DrEVILish/inferno-esp32-usb/docs/13-review-2026-10-13.md

# 13 — Cross-module review (A1), 2026-10-13

Scope: all of `firmware/main` after the merge of the three modules (usb/,
net/+clock/, aoip/), read at the seams: ring contracts, ISR/IRAM safety,
cores and priorities, init order, epoch handling, error paths, atomics. The
AoIP control plane (ARC, CMC, flow control, subscriber, mDNS, info) was
reviewed by a second reader in parallel. Nothing here has run on hardware.

Line numbers refer to branch `feat/harden` after the fixes.

## 1. Fixed

| # | where | severity | what went wrong | fix |
|---|---|---|---|---|
| 1 | `clock/mediaclock.c:100` `mc_hw_step`; `usb/uac2.c:126`; `aoip/flows_tx.c:313` | high | The step bumped the epoch *after* leaving its critical section, and the SOF ISR read `mc_now_ns()` then `mc_epoch()` (the packetizer the other way round). A step on core 0 between the two reads paired a time from one timescale with the epoch of the other: the USB engine re-anchored OUT/IN on the old timescale under the new epoch, then saw a jump (`sof_gaps`/refit, IN re-anchor = audible); the packetizer bootstrapped flows on the wrong timescale and reset them again. | `mc_now_ns_epoch()` (IRAM): a seqlock reader. The step brackets the counter write *and* the epoch increment with a sequence counter inside the critical section. Both audio users read the pair through it. |
| 2 | USB interrupt (TinyUSB `dwc2_esp32.h`) | high | Allocated without `ESP_INTR_FLAG_IRAM`, handler and `dcd_dwc2.c`/`usbd.c` in flash: every NVS write masked USB for its whole duration (ms; tens of ms for an erase) → OUT/IN re-anchors. | A2: `esp_intr_alloc` wrapped at link time (`-Wl,--wrap`), IRAM flag added for `ETS_USB_OTG_INTR_SOURCE`; `main/linker.lf` moves TinyUSB's ISR path to IRAM/DRAM; `tools/check_iram.py` proves the call graph after each build (§3). |
| 3 | `app_config.h:167` `UI_PRIO_PTP` | med | PTP task and TX packetizer shared priority 22 on core 0. Before each Delay_Req the PTP task busy-waits up to ~1 ms for the TX DMA and then polls for the TX timestamp; at equal priority (no preemption) a due audio packet could wait past its 1 ms deadline. | PTP → 20 (below the packetizer, above everything on core 1 that matters). PTP needs no scheduling latency: all its timestamps are hardware. |
| 4 | `clock/ptpv1.c:179,377` | med | A Sync queued while the servo stepped the clock carried a pre-step t2; on the new timescale it reads as an offset of the whole step → the servo steps straight back (ping-pong) when two Syncs are queued around a step. | Events carry `mc_epoch()` from the hook; Syncs from an older epoch are dropped. |
| 5 | `aoip/settings_nvs.c` flush | low | `s_dirty` was cleared before `nvs_open`; on an error the change was never written. Error log printed a stale `err`. | A3 rewrite: dirty bits restored and retried after another quiet period; `err` set on every failure path. |
| 6 | `audio/ring.h` counters, `sys/telem.c` | low | `ring_n2u_underruns`, `ring_n2u_late`, `ring_u2n_underruns` were exported but never incremented, yet docs/21 uses `ring_*` as pass criteria. | Wired: TX packet from unwritten OUT frames, USB IN re-anchor, late RX packet. |
| 7 | `aoip/subscriber.c:188` | med | ARC unsubscribe followed quickly by subscribe: `sub_subscribe()` sets the status at once, then the *earlier* queued UNSUBSCRIBE wipes it and nothing restores it. ARC shows the channel unpatched while it is patched (and saved to NVS). | `subscribe_internal()` restores the status if an earlier unsubscribe cleared it. |
| 8 | `aoip/arc.c:193` | med | Renaming TX channel 1 to "02" (channel 2's factory name): the mDNS add fails, and renaming channel 1 back later removes *channel 2's* service. | A rename to a name another TX channel uses (factory or friendly) is refused. |
| 9 | `aoip/flowctl_server.c` | low | fpp 1 accepted (only 0 refused): a peer could make us send 48 k packets/s per flow. | `fpp < TX_FPP_MIN` → 0x0302, as Inferno. |
| 10 | `aoip/aoip.c:159` | low | `sub_start()` ran before `info_set_socket()` created the RX-channel notify queue: early notifications dropped, queue pointer published without ordering. | Subscriber task starts after the queue exists. |
| 11 | `aoip/subscriber.c:150` | low | Two 2 KB `saved_sub_t[32]` locals on the 6 KB subscriber stack. | `static` (subscriber task only). |
| 12 | `aoip/subscriber.c` flow request, `aoip/proto.h` | med (new with the latency profiles) | We asked transmitters for their maximum fpp (32 for Inferno = 0.67 ms) and advertised fpp 32 for our own TX, regardless of latency. At 0.5 / 0.25 ms AoIP latency every packet would be late. | fpp capped at `UI_TX_FPP_MAX` of the latency profile (32 at 1 ms, 8 at 0.5 ms, 4 at 0.25 ms); multicast bundles and mDNS `fpp=` follow it. |
| 13 | `usb/uac2.c` DMA buffers | build break (new) | `UAC2_EP_DATA_MPS % 64 == 0` asserted: only true for 16 and 32 channels. | Buffers rounded up to whole cache lines; the endpoint keeps the exact MPS. |
| 14 | `app_config.h` model strings | low (new) | "USB-Inferno 32x32" / `UI3232-` in every channel build. | Derived from `UI_CHANNELS` (32 → unchanged). |
| 16 | `audio/ring.h` `RING_FRAMES`, memory budget | high | Internal heap is ≈ 393 KB (768 KB L2MEM − 128 KB L2 cache − 72 KB ROM reserve − 188 KB static), not "768 KB minus a little". Two 1024-frame rings (256 KB) + EMAC DMA (96 KB at 30+30) left ≈ 40 KB for every task stack, lwIP and mDNS: very likely a boot failure (`ring_init`/EMAC alloc → abort) or starved lwIP. With A4's 64 RX buffers it would certainly not fit. | `RING_FRAMES` 1024 → 512 (10.7 ms; bounds: transmitter latency up to ours + 5.3 ms, OUT lead ≤ 5.3 ms, loopback delay 192 fit). `ENG_OUT_LEAD_MAX` follows the ring. Budget in docs/01 §8; `heap_internal_min_free` telemetry and a boot log line. |
| 15 | `usb/uac2_engine.h` OUT underrun thresholds | low (new) | `lead < 24` and `w − now < 12` were absolute; with a 12-frame lead they would re-anchor constantly. | `ENG_OUT_LEAD_MIN = max(4, lead/2)`, real-time check `(LEAD_MIN − 6)/2` (lead 48: 24/9, lead 12: 6/0). |

## 2. Checked, no change needed

- **Ring contracts.** Indices are media frames everywhere (RX: packet
  `sec·48000+sub` + shift; TX: packet timestamp = ring index of its first
  frame; USB: SOF media frame ± lead/latency). Samples are left-justified
  int32 on both sides (RX decode `<<8`/`<<16`, 32-bit input masked to 24;
  TX takes the top bytes). `net_to_usb` is read-and-cleared by USB IN only in
  production; the NET_LOOPBACK and USB_LOOPBACK builds never clear it (TX
  resp. nobody reads it). `ring_valid()` window `head − frame ≤ 960` holds
  with lead ≤ 48 + fpp ≤ 32 + lag ≤ 48.
- **RX late check vs IN read.** IN reads frames `< sof_f − L − m` (m = IN
  margin), `sof_f` on the lower envelope of SOF times, so never later than
  the read itself; the RX hook drops a packet if its first ring frame is
  `< now − L`. Any accepted frame is therefore unread, and a read frame is
  never written later, provided the hook writes within m frames (+ ISR
  latency) of reading `now` (it runs at the highest task priority, µs). With
  m = 3 frames (62 µs, was 6) — docs/14-latency.md.
- **64-bit atomics on rv32 (`audio_ring_t.head`).** Not lock-free: GCC emits
  `__atomic_load_8/__atomic_store_8`, which IDF's `esp_libc/stdatomic.c`
  implements with one global `portENTER_CRITICAL_SAFE` spinlock. That is
  correct across cores and in ISRs (SAFE variant), and the code is in IRAM
  (`CONFIG_LIBC_MISC_IN_IRAM=y`; `check_iram.py` walks into it). Cost: one
  short global spinlock per ring head access (USB ISR write, packetizer
  `ring_valid`). Acceptable; a seqlock or 32-bit head would remove it if
  profiling ever shows contention.
- **Cache maintenance for DMA.** TinyUSB cleans IN buffers before arming
  (`dcd_edpt_xfer`) and invalidates OUT buffers before the completion
  callback; our buffers are 64-byte aligned, whole lines, and the CPU never
  writes the OUT buffers (no dirty lines to evict over DMA data). The 4-byte
  feedback buffer is a full line.
- **Init order** (`app_main.c`): NVS → rings → `net_start` (esp_netif/lwIP
  init, EMAC, 1588 enable) → `mc_start` (counter init, PTP task/hook/join)
  → `uac2_start` (SOF ISR uses an initialised counter) → `aoip_start`
  (sockets after lwIP; binds to INADDR_ANY work before an address) →
  telemetry. Before link/IP: joins fail with INVALID_STATE and the
  `net_maint` task re-joins on link-up; TX destinations stay unresolved and
  are retried by `ftx_tick`.
- **Multicast contract.** RX bundles join via `net_mcast_join()` (239/8 fast
  path filter), PTP joins 224.0.1.129 the same way.
- **Test variant routing.** USB_LOOPBACK: IN reads `usb_to_net` at
  `now − 192` (non-clearing); NET_LOOPBACK: TX reads `net_to_usb` at
  `ts − L` without clearing, USB IN sends silence and never clears; TONE:
  TX ignores rings.
- **Stacks.** EMAC RX 6 KB (hooks use < 300 B), packetizer 4 KB (packet
  buffer static), USB task 4 KB (control requests only), ctl 8 KB, sub
  6 KB (after fix 11), telemetry 4 KB (8 KB buffer is static).
- **Integer wrap.** 64-bit frame indices everywhere on the audio path;
  32-bit ms timestamps compared by subtraction.

## 3. IRAM check (A2) — what it covers

`tools/check_iram.py <elf>` (run by `tools/build.sh` and
`tools/build-variant.sh` / `build-matrix.sh` after every build):

- Roots: `dwc2_int_handler_wrap` (TinyUSB DWC2 ISR), `uac2_sof_isr`,
  `uac2_xfer_isr` (called through the class driver table), the AoIP TX
  `timer_cb` (esp_timer ISR dispatch).
- Edges: direct calls/jumps, plus loaded function addresses (treated as
  possible indirect calls). Result today: 70 functions reachable, all in
  IRAM or ROM.
- Data: references to `.flash.rodata`/PSRAM fail the check for our code and
  TinyUSB (e.g. it caught `_dwc2_controller`, a const table in flash, before
  the linker fragment moved it). IDF's own IRAM functions reference flash
  only for assert strings; those are reported with `-v`, not failed.
- Justified exceptions (`ALLOW` in the script): FIFO mutex paths in
  `tusb_fifo.c` (no FIFO has a mutex: our driver uses plain buffers),
  `dcd_event_handler → xQueueGenericSend` (task branch; in the ISR it is the
  FromISR call), `prvCopyDataToQueue → xTaskPriorityDisinherit` (mutexes
  only).
- Not covered statically: the data the ISR touches through pointers set at
  run time (`g_ring_*.buf` from `heap_caps_aligned_calloc(INTERNAL|DMA)`,
  DMA buffers in `.bss`) — internal RAM by construction.
- `uac2_start()` logs an error if the `esp_intr_alloc` wrap did not run.

## 4. Not fixed (with reason)

| where | issue | why not now |
|---|---|---|
| `net/net.c` hooks | Re-registering a hook slot while the RX task is inside the old hook can call the new `fn` with the old range for one frame. | `net_udp_hook_unregister()` is never called; all hooks are registered once at start. |
| `aoip/aoip_mdns.c` A-record fallback | `mdns_query_a()` (3 s) runs per channel, serially; 32 subscriptions to one badly-announcing host can block the subscriber ~100 s. | Control-plane latency only; cache per hostname when it is seen on the bench. |
| `aoip/*` under `aoip_lock` | `frx_add_flow` quiesce (2 ms) and socket work, `publish()` waiting for the packetizer ack, NVS flush, `mdns_hostname_set` run under the recursive lock. | Stalls the ctl/sub tasks only (no lock-order cycle: tcpip, mdns, packetizer and the EMAC hook never take it). |
| `aoip/subscriber.c` | `fpp = max(fpp_min, …)` can exceed the latency cap / MTU when a transmitter's minimum is large. | The transmitter would refuse or we count `rx_late`; Dante/Inferno minimum is 2–16. |
| `aoip/flowctl_client.c` | OK reply shorter than 6 bytes: error returned, transmitter keeps the flow until keepalive timeout. | Harmless. |
| NVS blobs | Their size depends on `UI_CHANNELS`; flashing a different channel build drops names/subscriptions (length check → defaults). | Test builds only; production is one channel count. |
| Flash writes vs network | The network side (EMAC RX task, packetizer, lwIP) is flash-resident and pauses during an NVS write; USB keeps running (A2). | Moving the whole network fast path to IRAM is large; A3 makes writes rare and controller-initiated. Option for later: `CONFIG_SPI_FLASH_AUTO_SUSPEND` (P4 supports it; flash-part dependent). |
| USB OUT lead vs ISR stalls | No lead ≤ 1 ms absorbs a 1 ms USB ISR blackout without an OUT re-anchor (simulated). | Post-A2 there is no known source of ms stalls; docs/14 states the assumption. |
| `tools/aoip_probe.py` `paged()` | Pages 0x2200/0x3200 by count instead of slot index; sparse tables page wrongly. | Bench tool; fix when used against sparse tables. |

## 5. Follow-up fixes on main

Without hardware; each is control-plane only and keeps the audio-path contracts
of §2 (hook/packetizer never take `aoip_lock`).

- **A-record fallback cache** (`aoip/aoip_mdns.c`): hostname→IPv4 cache
  (`s_host_cache`, 8 entries, round-robin eviction) in front of `mdns_query_a()`,
  refreshed whenever an SRV answer already carries an IPv4 address. Worst case
  for 32 subscriptions to one badly-announcing host drops from ~32 × 3 s to
  ~1 × 3 s. Cache lives in the subscriber task (sole caller of
  `aoip_mdns_query_chans`); no locking.
- **fpp clamp** (`aoip/subscriber.c`, new `aoip/fpp.h`): `fpp_min` above the
  MTU cap now refuses the flow (`SUB_STATUS_TX_FAIL`) instead of requesting
  fragmenting packets that `net.c` drops; above only the latency cap it requests
  the minimum with a warning (degraded, counted in `rx_late`). Selection logic
  is pure and host-tested (`tools/fpp_select_test.c`).
- **Lock scope** (`aoip/aoip.c`, `aoip/flows_rx.c`, `aoip/arc.c`,
  `aoip/aoip_mdns.c`): `settings_flush_if_due()` (NVS commit, self-locking)
  and the deferred device-rename `aoip_mdns_publish_all()` now run after the
  ctl-loop `aoip_unlock()`; `frx_add_flow`/`frx_remove_flow` open/close the
  keepalive sockets, IGMP join/leave, and `quiesce()` outside the lock (lock
  covers only the state swap; the hook bails on inactive slots);
  `frx_connect/disconnect_channel` run `rebuild_map()` (possible 2 ms quiesce)
  unlocked — only the subscriber task mutates the channel map, and the hook
  reads the new table through the `map_idx` acquire/release handoff.
  Still under the `serve()` hold by design (handlers assume it; audit-free):
  the whole ARC/CMC/FCS dispatch and `publish()`'s packetizer-ack wait.

## 6. Critical/warning fixes on main (2026-10-14)

Traced with the Code Mode tool catalog review. Each verified against the
sources; the clock fixes are the ones that previously left the servo chasing
a phantom.

| # | where | what was wrong | fix |
|---|---|---|---|
| 1 | `mediaclock.c` step/freq | `mc_hw_step()` ignored the `hw_set_time()` failure and bumped the epoch anyway: the servo believed the step applied when the clock never moved — non-converging step loop on a wedged `wait_ctrl_idle()`. `mc_hw_set_freq_ppb()` silently skipped the addend with no signal. | both return `bool`; epoch/seq no longer move on a failed step; failure counters `ptp_hw_step_fails`/`ptp_hw_freq_fails` in telemetry; `apply()` keeps in-flight timestamps on a failed step (they are still on the current timescale). |
| 2 | `uac2_engine.c` `eng_in_packet` | rendered + cleared + advanced `r` before the arm result: a persistent `usbd_edpt_xfer` failure silently discarded fresh RX audio every microframe. | split into `eng_stage_in_packet` (render, no consume) + `eng_commit_in_packet` (advance + clear + counters, only after arm success); `arm_in()` stages, arms, commits. `eng_in_packet` = stage+commit for the host sim. |
| 3 | `uac2_engine.c` gap fill | the fill cap scaled with the unbounded `gap`; a huge fill jumped the ring head far past `now` before the overrun re-anchor ran. | fill is skipped when the estimate exceeds `ENG_OUT_LEAD_MAX` (discontinuity, not a gap): the re-anchor handles it with a bounded position reset. |
| 4 | `audio/ring.c` head | `ring_write_frames/silence` stored `head = frame + n` unconditionally: an out-of-order/re-anchor write regressed the published head (previously valid ranges read as underruns; content/reader overlaps possible). | `ring_publish_head()`: monotone — head only advances. |
| 5 | `uac2.c` stale OUT completion | a completion latched before SET_INTERFACE could be consumed as the new session's first packet. | session era: `s_out_era` bumped per set_interface, arm records its era, mismatched completions are swallowed. |
| 6 | `tx_multicasts.c` remove | bundle state was cleared before the TX-flow removal was known to succeed → device kept streaming a multicast that persisted state no longer knew. | remove the flow first; only on success clear + mDNS-remove + persist. |
| 7 | `flowctl_server.c` | destination never sanity-checked (any LAN datagram could point the 32-ch TX stream anywhere, including through the gateway); every `ftx_add_flow` failure was reported as 0x0315. | refuse 0.0.0.0 / 255.255.255.255 / 127/8 / port 0 (0x0302); `ESP_ERR_NO_MEM` → 0x0315, others → 0x0302. |
| 8 | `info_mcast.c` | unauthenticated info requests entered at line rate (each answered with a byte-heavy multicast). | token bucket (1 per 250 ms, burst 32); refusals counted (`aoip_info_drops`). |
| 9 | `ptpv1.c` bring-up | hook-registration failure left a permanently dead follower (log-only, no retry). | retry from `ptp_task` before its main loop (6 × 5 s), then a permanent-failure log; mcast join failure tolerated — `net_maint` re-joins every second while the link is up. |
| 10 | `ptp_servo.c` HOLD_MAX | unlock left the outlier window stale → median mixed pre/post-re-anchor samples. | `outl_n = 0` like the other unlock path. |
| 11 | `uac2.c` open/set_interface | endpoint alloc/activate failures had no counter and no log; `uac2_start()` timeout leaked the usb task and double-initialised on retry; GET controls ignored `wLength`; unknown-EP completions were claimed as handled. | `usb_ep_errors` counter + logs; `started` set before the wait (no second task); `wLength` guards on the three GET paths; `xfer_isr` returns false for foreign EPs. |
| 12 | Wires hardening | device rename accepted non-NUL-terminated/over-long names silently and skipped the fork's first-char/trailing-'-' rules. | NUL required, ≤ 30 chars, starts with a letter, no trailing '-'. |
| 13 | Engine IN re-anchor | `reanchor_in(target − NOMINAL)` underflowed at early boot (`target < 6`). | clamped like `reanchor_out`. |
| 14 | tools | PID-predictable /tmp dirs (compiled binaries executed from them), `esp_eth_override` `rm -rf` before validating the source + default fuzz patching, `check_iram` mislabelled tool errors as violations, descriptor checker crashed on malformed input, fixed `/tmp` build lock, unvalidated variant name injected into Kconfig, `net_stats` tracebacked on bad args/DNS, `usb_loopback_test` leaked its temp dir. | mktemp everywhere; pre-validate + `patch --fuzz=0` +  `.rej` check + dry-run; exit 2 for tool errors; bounded descriptor walk; per-user lock; variant regex; guarded parsing; try/finally cleanup. |

Known-but-not-fixed here (bench-verified prerequisites): the EMAC RX
malloc/copy tax, peak metering in the decode loop, per-packet esp_timer
wake economics, and the `serve()` lock audit — all gated behind
`docs/15-profile.md` measurements. The `ring_read_frames_and_clear`
read/clear window (1.5 in the review) is a design-margin issue documented
in docs/13 §2, not a defect fixable at the access layer.
