DrEVILish/inferno-esp32-usb/docs/40-board-rev1.md

# 40 — Own board, rev 1 (USB-C + RJ45, ESP32-P4 chip-down)

Status: **schematic complete as code, ERC clean, board outline/stackup/placement of the
key parts done, not routed.** Everything in `hardware/` is generated by
`hardware/build.sh`; see `hardware/README.md` for the tool flow.

The box does exactly two things: AoIP (Inferno-compatible, 10/100 RMII with the EMAC's
IEEE 1588 timestamps) on an RJ45, and USB Audio Class 2.0 (32×32, HS) on a USB-C port.
It is bus powered, has no buttons and no configuration, and boots on power. The
firmware is the one that runs today on the Waveshare ESP32-P4-ETH. Rev 1 keeps all of
its Ethernet pins (§5) and needs only the deltas in §15.

Facts are tagged with their source. A fact this pass could not check is marked
**UNVERIFIED**.

## 0. Sources

The documents were downloaded to `work/board-refs/` (gitignored, not committed).

| tag | document | where |
|---|---|---|
| [DS] | ESP32-P4 Series Datasheet, Pre-release **v0.7** (covers ESP32-P4NRW16X/32X, chip rev v3.x) | documentation.espressif.com/esp32-p4_datasheet_en.pdf |
| [HDG] | ESP32-P4 Hardware Design Guidelines, release *master*, dated 2026-10-12. Fig. 1 is the **v3.x reference schematic**, Fig. 5 the TLV62569 VDD_HP circuit | docs.espressif.com/projects/esp-hardware-design-guidelines/…/esp32p4 |
| [REV3] | ESP32-P4 Chip Revision v3.x User Guide **v1.1** (2026-08) | documentation.espressif.com/esp32-p4-chip-revision-v3.x_user_guide_en.pdf |
| [PCN] | PCN202600801 "ESP32-P4 Chip Revision v3.2 Upgrade…", issued 2026-05-20 | documentation.espressif.com/en/PCN202600801_… (HTML) |
| [EVX] | ESP32-P4X-C5-Function-EV-Board schematic **v2.0** (2026-02-26), the v3.x EV board | dl.espressif.com/schematics/ESP32_P4X_C5_Function_EV_board-2.0-schematics.pdf |
| [WS] | Waveshare ESP32-P4-ETH "datasheet" PDF. It is the 3-page schematic of the board we run on today | files.waveshare.com/wiki/ESP32-P4-ETH/ESP32-P4-ETH-datasheet.pdf |
| [IP] | IC Plus IP101G Preliminary Data Sheet IP101G-DS-R01 (IP101GR/GRI pin table, Table 3, §6, §7.4, Fig. 25) | bdtic mirror (no IC Plus original found) |
| [TPS] | TI TPS25200 SLVSCJ0F (Jul 2025) | ti.com/lit/ds/symlink/tps25200.pdf |
| [TLV] | TI TLV62569 SLVSDG1C | ti.com/lit/ds/symlink/tlv62569.pdf |
| [TPD] | TI TPD2EUSB30 data sheet | ti.com/lit/ds/symlink/tpd2eusb30.pdf |
| [SY] | Silergy SY6280 (prelim. Rev 0.3). Evaluated, **not used** | olimex mirror |

## 1. Block diagram

```
            USB-C (UFP, Rd 5k1 x2)                                RJ45 HR911105A (magjack, 2 LEDs)
            |  VBUS     | D+/D-                                     | MDI TX/RX pairs (100R diff)
        TVS SMAJ5.0A   TPD2EUSB30 (0.7 pF)                           |
            |           | 0R (at P4)                             IP101GRI (RMII, addr 1)
      TPS25200 eFuse    +------------> P4 USB_DP/DM (HS OTG)          ^  | RMII 50R, 22R series
   (soft start, 650 mA, 5.4 V clamp)                                  |  v
            | VBUS_5V                    +--------------------- ESP32-P4NRW32X (rev v3.x, QFN104)
      TLV62569 #1  5V->3V3 (2 A)         |  GPIO28-31,34,35,49-52 RMII/MDIO/RST  | FLASH_* QSPI
            | +3V3 ---------------------+--> all VDD_IO/LP/ANA/LDO/DCDCC/USBPHY | W25Q128JV 16 MB
      TLV62569 #2  3V3->VDD_HP (~1.1 V, EN/FB driven by P4 EN_DCDC/FB_DCDC)   |  (VDDO_FLASH 3.3 V)
                                         |  XTAL 40 MHz +-10 ppm               |
   50 MHz XO (+-25 ppm) --22R--> P4 GPIO50 (REF_CLK in)                        |
                        --22R--> IP101 50M_CLKI                                |
   Tag-Connect TC2030: 3V3, EN, GND, U0TXD(37), U0RXD(38), BOOT(35)            |
   Test pads: USB-Serial-JTAG D+/D- (GPIO25/24), 5V, 3V3, VDD_HP, GND, FAULT, IO36
   Status LED: GPIO20 (active high)
```

## 2. Parts

| function | part | why | LCSC |
|---|---|---|---|
| SoC | **ESP32-P4NRW32X**, rev v3.x, QFN104 10×10 mm, 0.35 mm pitch, 32 MB 1.8 V PSRAM in package [DS 1.2, 6] | fixed by the requirements. [PCN] says it replaces ESP32-P4NRW32 (v1.3). The older part is going EOL and its v1.3 silicon is "not hardware-compatible" (pin 54) | **none found (UNVERIFIED)**. Not listed on LCSC in this pass. A forum report (esp32.com, 2026-07) says the X part is in mass production. Plan on consigning parts to JLC or using JLC global sourcing |
| flash | **W25Q128JVSIQ** 16 MB, 3.3 V, SOIC-8 208 mil | VDDO_FLASH defaults to 3.3 V [DS 3.2], so a 3.3 V flash needs no eFuse step. Avoids the 1.8 V flash damage risk in [HDG 1.3.2]. The firmware uses < 4 MB | C97521 (checked) |
| PHY | **IP101GRI** QFN32 **4×4 mm**, 0.4 mm pitch, −40…85 °C [IP] | same PHY as [WS]/[EVX], so the firmware is unchanged | C703537 IC Plus (checked); C910373 lists the same MPN under "WIZNET" |
| RMII clock | **ECS-3225MV-500-CN-TR** 50 MHz CMOS XO, 1.62–3.63 V, ±25 ppm, 3225 4-pad (option A, fitted) | required. See §7.2 for how [WS] differs | C405974 (checked) |
| PHY crystal (DNP) | **YXC X322525MSB4SI** 25 MHz 3225 + 2× 20 pF (option B, not fitted) | fallback to the proven [WS]/[EVX] scheme, chosen by population only (§7.2) | C13740 (checked); its CL vs the 20 pF caps is UNVERIFIED |
| P4 crystal | **YXC X322540MPB4SI** 40 MHz, 15 pF, ±10 ppm, 3225 | [HDG 1.3.5]: 40 MHz only, ≤ ±10 ppm | C9010 (checked) |
| magjack | **HanRun HR911105A** (1:1, 2 LEDs, Bob-Smith 75R + 1 nF) | standard JLC part, KiCad symbol and footprint exist | C12074 (checked via the KiCad symbol datasheet link) |
| USB-C | **HRO TYPE-C-31-M-12** 16-pin | standard JLC part, KiCad footprint exists | C165948 (checked) |
| USB ESD | **TPD2EUSB30DRTR**, 0.7 pF typ [TPD] | [HDG 1.3.12] asks for ≤ 1 pF on HS lines | C97502 (checked) |
| VBUS protection | **TPS25200DRVR** eFuse: IN tolerates 20 V, OUT clamps at 5.4 V, OVLO 7.6 V, built-in soft start, ILIM by resistor [TPS] | gives OV, OC and inrush control in one 2×2 mm part. SY6280 [SY] has a 6 V abs max with no OV clamp, so it was rejected | C128401 (checked) |
| VBUS TVS | SMAJ5.0A (SMA) | surge and ESD ahead of the eFuse | C83329 (**recall**, verify manufacturer and stock) |
| 3V3 buck | **TLV62569DBVR** 2 A, 1.5 MHz | the same part and values as the [EVX] 3V3 rail | C141836 (checked) |
| VDD_HP buck | **TLV62569DBVR** | on Espressif's verified-DCDC list [HDG 1.3.2]; circuit as [HDG Fig. 5] | C141836 |
| inductors | cjiang FNR4020S2R2MT 2.2 µH, Isat 3.7 A, 4×4 mm | 2.2 µH per [TLV]/[HDG Fig. 5]; exact KiCad footprint | C167825 (checked) |
| status LED | green 0603 | | C72043 (recall) |

Passives are Samsung/UNI-ROYAL JLC basic parts. Their LCSC numbers are marked
`recall` in `hardware/bom.csv`, meaning they were taken from memory of the basic
library and not re-checked here. Run the BOM through JLC's BOM tool before
ordering. Two values have no LCSC number yet (`TBD`): 499 kΩ 1 % and 6.19 kΩ 1 % (0402).

## 3. Power

### 3.1 Rail requirements (verified)

| pin(s) | requirement | source | rev 1 |
|---|---|---|---|
| VDD_LP (9), VDD_IO_0/4/5/6 (21/62/85/96) | 3.0–3.6 V (LP); 1.65–3.6 V (IO); 0.1 µF each, 10 µF at entry | [HDG 1.3.2, 1.4.1] | +3V3 |
| VDD_ANA (101) | 3.0–3.6 V, 0.1 µF | [HDG] | +3V3 |
| VDD_BAT (102) | 2.5–3.6 V, **must not float**, 0.1 + 10 µF | [HDG] | +3V3 via 0R (R5 in [HDG Fig. 1]) |
| VDD_LDO (75), VDD_DCDCC (77) | 3.0–3.6 V, high current, 10 µF + 0.1 µF at each | [HDG] | +3V3 |
| VDD_HP_0/1/2/3 (26/54/76/91) | 0.99–1.3 V (typ 1.1), abs max 1.3 V; core ≥ 0.5 A [DS 5.2]; external DCDC, EN/FB owned by the P4 | [DS Table 5-2], [HDG] | TLV62569 #2 |
| **pin 54** | **VDD_HP_1 on v3.x** (NC on v1.x). [PCN]: must go to VDD_HP or "USB, SDIO and GMAC" misbehave | [REV3 2.1.1], [PCN] | VDD_HP + 0.1 µF |
| FB network | v3.x **must fit** 499 k / 499 k + 22 pF (v1.x had them unpopulated) | [HDG 1.3.2, Fig. 5], [REV3] | fitted |
| VDD_USBPHY (51) | 2.97–3.63 V, ≤ 20 mA; 10 nF + 0.1 µF + 4.7 µF; 0R series kept for compatibility | [HDG USB PHY] | +3V3 via 0R |
| VDD_FLASHIO (30) ← VDDO_FLASH (71) | flash LDO, 3.3 V by default (1.8 V only after burning EFUSE_0PXA_TIEH_SEL_0), ≤ 50 mA; condition VDD_LDO > Vflash_min + Iflash·RVFB (3 Ω) | [DS 3.2, 5.3], [HDG] | 3.3 V flash on VDDO_FLASH; 3.0 > 2.7 + 0.025·3 ✓ |
| VDD_PSRAM_0/1 (59/67) ← VDDO_PSRAM (72) | 1.65–1.95 V, internal LDO (≈1.9 V, software-enabled); 0.1 + 1 µF | [HDG], [DS Table 2-13] | as reference |
| VDDO_3/4 (73/74) | LDO outputs, 1 µF | [HDG Fig. 1] | unused, 1 µF each |
| VDD_MIPI_DPHY (41), DSI/CSI_REXT | may float if MIPI is unused | [HDG 1.3.15] | NC |
| USB PHY reference resistor | **none.** The P4 HS PHY has no REXT pin. The only REXT pins are MIPI DSI/CSI [DS Table 2-9/2-10] | [DS] | n/a |
| CHIP_PU (103) | must not float; RC 10 k / 1 µF; t_STBL ≥ 50 µs, t_RST ≥ 1 ms | [HDG 1.3.3], [DS Table 2-14] | 10 k / 1 µF |

### 3.2 Power tree

```
VBUS_C (USB-C, 4.40–5.25 V; 1 µF + 0.1 µF, TVS)            [< 10 µF ahead of the switch]
 └─ TPS25200 (ILIM 150 k → 590–710 mA, soft start ~2–3 ms, 5.4 V clamp, 7.6 V OVLO, EN = VBUS/2)
     └─ VBUS_5V (10 µF + 4.7 µF)
         └─ TLV62569 #1, 100 k / 22 k → 3.33 V, 2× 22 µF                       +3V3 (≤ 2 A)
             ├─ P4 3V3 domains (LP, IO_0/4/5/6, ANA, BAT, LDO, DCDCC, USBPHY)
             ├─ TLV62569 #2 (EN = P4 EN_DCDC, FB = P4 FB_DCDC + 499 k/499 k/22 p) → VDD_HP ≈ 1.1 V, 22 µF + 10 µF
             ├─ W25Q128 via P4 VDDO_FLASH (3.3 V)
             ├─ PHY_3V3 (0R) → IP101GRI VDDIO + AVDD33, 50 MHz XO (0R, ferrite option), magjack yellow LED
             └─ status LED
```

Rationale for the VDD_HP buck: [HDG 1.3.2] requires it and also requires that "the
input of the external DCDC is the same as the VDD_DCDCC power supply". That is +3V3,
not VBUS. EN_DCDC is 0 V in download mode and before firmware runs [HDG], so the core
supply comes up under ROM control.

### 3.3 Power budget (USB 2.0 high-power: 500 mA at ≥ 4.40 V at the device)

| load (3.3 V) | typical | design max | basis |
|---|---:|---:|---|
| ESP32-P4 at 400 MHz, both cores busy, all peripheral clocks on, incl. VDD_HP buck input | 150 mA | — | [DS Table 5-7] "Typ2" 150 mA (3.3 V supply, 25 °C) |
| + PSRAM/flash traffic, USB HS PHY (≤ 20 mA [HDG]), EMAC | +60 mA | — | estimate (UNVERIFIED); the PHY and flash figures are maxima |
| P4 incl. flash and PSRAM, design figure | — | **380 mA** | [HDG 1.3.2]: "minimum operating supply current 380 mA (including flash and PSRAM)" |
| IP101GRI, 100BASE-TX full load | 45 mA | 50 mA | [IP Table 1] ≈ 150 mW |
| 50 MHz XO | 5 mA | 10 mA | ECS-3225MV class (UNVERIFIED, datasheet not read) |
| LEDs (link, speed, status) | 3 mA | 5 mA | ~1–1.5 mA each, through 1 k |
| eFuse quiescent, pull-ups, dividers | 0.5 mA | 1 mA | [TPS] |
| **3V3 total** | **≈ 265 mA** | **≈ 445 mA** | |
| **VBUS input** (buck η ≈ 0.90 typ / 0.85 worst) | 265·3.3/(5.0·0.90) ≈ **195 mA** | 445·3.3/(4.40·0.85) ≈ **393 mA** | |

The board stays under 500 mA even at the 380 mA Espressif design figure and the
minimum USB voltage. That leaves about 100 mA of margin. The eFuse limit (590 mA
minimum) sits above the worst case and below what a USB 2.0 port must supply.
**USB descriptor: `bMaxPower` = 400 mA** (the field is in 2 mA units, so the value
is 200). That covers the 393 mA worst case and stays below the 500 mA high-power limit
(firmware item, §15).

**Known deviation: unconfigured current.** USB 2.0 §7.2.1 allows a device only one unit
load (100 mA) until the host sends SET_CONFIGURATION. This box draws about 195 mA from
VBUS as soon as it is attached: the P4 runs at full clock and the PHY and 50 MHz XO run
at once. Hosts and hubs tolerate this in practice, but it is not compliant. Bench-test
the figure (UNVERIFIED on hardware). **Mitigation (firmware, no hardware change):**
until SET_CONFIGURATION, keep GPIO51 low so the PHY stays in reset (the 10 k
pull-down already holds it there from power-up, saving ≈45 mA), run the CPU at a low
clock (e.g. 40–100 MHz; [DS Table 5-7] gives 40–63 mA at 100 MHz against 150 mA at
400 MHz), and keep the AoIP stack idle. Then raise to 400 MHz and release the PHY in
the set-config callback. This should bring the attach current to roughly 80–100 mA
(estimate, UNVERIFIED). The cost is that Ethernet only starts once a USB host has
configured the device. That is acceptable, because the box is useless without USB.
The XO cannot be gated (no enable line is wired); its ≤ 10 mA is part of that figure.

## 4. Strapping configuration

[DS §3, Table 3-1/3-3/3-7], [HDG 1.3.8]

| strap | default | rev 1 | effect |
|---|---|---|---|
| GPIO35 (also RMII TXD1) | weak pull-up = 1 | **10 k pull-up**, BOOT pin on the Tag-Connect | 1 = SPI boot. Pulling BOOT low during reset gives Joint Download (USB-Serial-JTAG, UART0, …). No capacitor on GPIO35 [HDG]. IP101 TXD1 is a Hi-Z input with no internal pull [IP pin table], so the PHY cannot pull the strap low. The 22 R series resistor sits on the PHY side, and the PHY is held in reset (Hi-Z) by its 10 k pull-down |
| GPIO36 | floating | **10 k pull-up** + test pad | Joint Download needs GPIO36 = 1 [DS Table 3-3]; with EFUSE_UART_PRINT_CONTROL = 0 it does not affect ROM printing |
| GPIO37/38 (UART0) | floating | UART0 TX/RX to the Tag-Connect | "any value" in Table 3-3 |
| GPIO34 (also RMII TXD0) | floating, no internal pull | no pull (same as [WS]/[EVX]) | JTAG source select is used **only** if EFUSE_JTAG_SEL_ENABLE = 1. Default eFuses ignore it [DS Table 3-7]. Never burn that eFuse on this board |
| VDDO_FLASH voltage | eFuse 0 → 3.3 V | not burned | 3.3 V flash |

IP101GRI latched pins, 5.1 kΩ each per [IP Table 12], as in [WS]:
COL/RMII = 1 (RMII), CRS/LEDMOD = 1 (LED mode 2: LED0 = link/act, LED3 = 100M link),
PHY_AD0 = 1 and PHY_AD3 = 0 (**PHY address 1**, as the firmware expects),
RXDV/CRS_DV/FX_HEN = 0 by internal pull-down (twisted pair, not fiber).
TXER is pulled down because "TXER must be floating or GND in RMII mode" [IP pin 1].
The magjack LED polarity follows the straps: the yellow LED goes from PHY_3V3 to LED0,
the green LED from LED3 to GND.

## 5. Pin allocation

### 5.1 ESP32-P4NRW32X (U1). Every package pin, generated from the netlist by `hardware/tools/pin_table.py U1`

The RMII/MDIO/reset pins are exactly those in `firmware/main/app_config.h`
(MDC 31, MDIO 52, RST 51, REF_CLK 50, TX_EN 49, TXD0 34, TXD1 35, CRS_DV 28,
RXD0 29, RXD1 30). They are also the [HDG Table 9] EMAC pin options that [WS]/[EVX]
use. [WS] confirms GPIO51 → IP101 RESET_N (pin 32), which closes the open question in
docs/11 §1.

| pin | name | net | notes |
|---:|---|---|---|
| 1 | GPIO1 | NC | unused (XTAL_32K_P alt.) |
| 2 | GPIO2 | NC | unused; MTCK, IE+WPU after reset |
| 3 | GPIO3 | NC | unused; MTDI |
| 4 | GPIO4 | NC | unused; MTMS |
| 5 | GPIO5 | NC | unused; MTDO |
| 6 | GPIO6 | NC | unused, no connect |
| 7 | GPIO7 | NC | unused, no connect |
| 8 | GPIO8 | NC | unused, no connect |
| 9 | VDD_LP | +3V3 | 3V3 + 100n |
| 10 | GPIO9 | NC | unused, no connect |
| 11 | GPIO10 | NC | unused, no connect |
| 12 | GPIO11 | NC | unused, no connect |
| 13 | GPIO12 | NC | unused, no connect |
| 14 | GPIO13 | NC | unused, no connect |
| 15 | GPIO14 | NC | unused, no connect |
| 16 | GPIO15 | NC | unused, no connect |
| 17 | GPIO16 | NC | unused, no connect |
| 18 | GPIO17 | NC | unused, no connect |
| 19 | GPIO18 | NC | unused, no connect |
| 20 | GPIO19 | NC | unused, no connect |
| 21 | VDD_IO_0 | +3V3 | 3V3 + 100n |
| 22 | GPIO20 | LED_STATUS | status LED, active high, 1k |
| 23 | GPIO21 | NC | unused, no connect |
| 24 | GPIO22 | NC | unused, no connect |
| 25 | GPIO23 | NC | unused, no connect |
| 26 | VDD_HP_0 | VDD_HP | VDD_HP + 100n |
| 27 | FLASH_CS | FLASH_CS | 10k pull-up to VDDO_FLASH |
| 28 | FLASH_Q | FLASH_Q |  |
| 29 | FLASH_WP | FLASH_WP |  |
| 30 | VDD_FLASHIO | VDDO_FLASH |  |
| 31 | FLASH_HOLD | FLASH_HOLD |  |
| 32 | FLASH_CK | FLASH_CK_P4 | via 0R (+22p DNP) to flash CLK |
| 33 | FLASH_D | FLASH_D |  |
| 34 | DSI_REXT | NC | MIPI unused: float |
| 35 | DSI_DATAP1 | NC | MIPI unused, no connect |
| 36 | DSI_DATAN1 | NC | MIPI unused, no connect |
| 37 | DSI_CLKN | NC | MIPI unused, no connect |
| 38 | DSI_CLKP | NC | MIPI unused, no connect |
| 39 | DSI_DATAP0 | NC | MIPI unused, no connect |
| 40 | DSI_DATAN0 | NC | MIPI unused, no connect |
| 41 | VDD_MIPI_DPHY | NC | MIPI unused: may float (HDG 1.3.15) |
| 42 | CSI_DATAN0 | NC | MIPI unused, no connect |
| 43 | CSI_DATAP0 | NC | MIPI unused, no connect |
| 44 | CSI_CLKP | NC | MIPI unused, no connect |
| 45 | CSI_CLKN | NC | MIPI unused, no connect |
| 46 | CSI_DATAN1 | NC | MIPI unused, no connect |
| 47 | CSI_DATAP1 | NC | MIPI unused, no connect |
| 48 | CSI_REXT | NC | MIPI unused: float |
| 49 | USB_DM | USB_D- | HS OTG D- (0R at chip -> ESD -> USB-C) |
| 50 | USB_DP | USB_D+ | HS OTG D+ (0R; 1M DNP pull-down) |
| 51 | VDD_USBPHY | VDD_USBPHY | 3V3 via 0R, 10n+100n+4.7u |
| 52 | GPIO24 | USJ_DM | USB-Serial-JTAG D- -> test pad (FS, prod/debug) |
| 53 | GPIO25 | USJ_DP | USB-Serial-JTAG D+ -> test pad; USB_PU after reset |
| 54 | VDD_HP_1 | VDD_HP | pin 54: VDD_HP_1 on rev v3.x (NC on v1.x). Mandatory (PCN202600801) |
| 55 | GPIO26 | NC | unused, no connect |
| 56 | GPIO27 | NC | unused, no connect |
| 57 | GPIO28 | RMII_CRS_DV | RMII CRS_DV (22R at PHY) |
| 58 | GPIO29 | RMII_RXD0 | RMII RXD0 (22R at PHY) |
| 59 | VDD_PSRAM_0 | VDDO_PSRAM | VDDO_PSRAM + 100n |
| 60 | GPIO30 | RMII_RXD1 | RMII RXD1 (22R at PHY) |
| 61 | GPIO31 | MDC | MDC |
| 62 | VDD_IO_4 | +3V3 | 3V3 + 100n |
| 63 | GPIO32 | NC | unused, no connect |
| 64 | GPIO33 | NC | unused, no connect |
| 65 | GPIO34 | RMII_TXD0 | RMII TXD0 (22R at P4). STRAP: JTAG source, only with EFUSE_JTAG_SEL_ENABLE=1 (default ignored) |
| 66 | GPIO35 | RMII_TXD1 | RMII TXD1 (22R at P4) + Tag-Connect BOOT. STRAP: boot mode, 10k pull-up -> SPI boot |
| 67 | VDD_PSRAM_1 | VDDO_PSRAM | VDDO_PSRAM + 100n |
| 68 | GPIO36 | GPIO36 | STRAP: 10k pull-up (=1, needed for Joint Download when GPIO35=0); test pad |
| 69 | GPIO37 | U0TXD | UART0 TXD -> Tag-Connect. STRAP (GPIO37/38: see TRM; float = any) |
| 70 | GPIO38 | U0RXD | UART0 RXD -> Tag-Connect |
| 71 | VDDO_FLASH | VDDO_FLASH | 3.3 V default (eFuse 0PXA_TIEH_SEL_0 = 0) -> VDD_FLASHIO + flash VCC, 1u |
| 72 | VDDO_PSRAM | VDDO_PSRAM | -> VDD_PSRAM_0/1, 1u |
| 73 | VDDO_3 | VDDO_3 | unused LDO out, 1u |
| 74 | VDDO_4 | VDDO_4 | unused LDO out, 1u |
| 75 | VDD_LDO | +3V3 | 3V3 + 100n + 10u |
| 76 | VDD_HP_2 | VDD_HP | VDD_HP + 100n |
| 77 | VDD_DCDCC | +3V3 | 3V3 + 100n + 10u |
| 78 | FB_DCDC | FB_DCDC | -> FB node 499k/499k + 22p |
| 79 | EN_DCDC | EN_DCDC | -> TLV62569 EN (0 V in download mode) |
| 80 | GPIO39 | NC | unused, no connect |
| 81 | GPIO40 | NC | unused, no connect |
| 82 | GPIO41 | NC | unused, no connect |
| 83 | GPIO42 | NC | unused, no connect |
| 84 | GPIO43 | NC | unused, no connect |
| 85 | VDD_IO_5 | +3V3 | 3V3 + 100n |
| 86 | GPIO44 | NC | unused, no connect |
| 87 | GPIO45 | NC | unused, no connect |
| 88 | GPIO46 | NC | unused, no connect |
| 89 | GPIO47 | NC | unused, no connect |
| 90 | GPIO48 | NC | unused, no connect |
| 91 | VDD_HP_3 | VDD_HP | VDD_HP + 100n |
| 92 | GPIO49 | RMII_TX_EN | RMII TX_EN (22R at P4) |
| 93 | GPIO50 | REF_CLK_MAC | RMII REF_CLK in, 50 MHz from X1 via 22R |
| 94 | GPIO51 | PHY_RST_N | PHY RESET_N, 10k pull-down (PHY held in reset until firmware) |
| 95 | GPIO52 | MDIO | MDIO, 1.5k pull-up |
| 96 | VDD_IO_6 | +3V3 | 3V3 + 100n |
| 97 | GPIO53 | NC | unused, no connect |
| 98 | GPIO54 | NC | unused, no connect |
| 99 | XTAL_N | XTAL_N | 40 MHz via 0R |
| 100 | XTAL_P | XTAL_P | 40 MHz via 0R |
| 101 | VDD_ANA | +3V3 | 3V3 + 100n |
| 102 | VDD_BAT | VDD_BAT | 3V3 via 0R, 10u + 100n (must not float) |
| 103 | CHIP_PU | CHIP_PU | RC 10k/1u; Tag-Connect EN |
| 104 | GPIO0 | NC | unused (LP IO, XTAL_32K_N alt.) |
| 105 | GND | GND | exposed pad, 3x3 vias |

### 5.2 IP101GRI (U6)

| pin | name | net |
|---:|---|---|
| 1 | TXER/FXSD | PHY_TXER |
| 2 | X1 | PHY_X1 |
| 3 | X2 | PHY_X2 |
| 4 | COL/RMII | PHY_COL_RMII |
| 5 | TXEN | PHY_TXEN |
| 6 | TXD3 | GND |
| 7 | TXD2 | GND |
| 8 | TXD1 | PHY_TXD1 |
| 9 | TXD0 | PHY_TXD0 |
| 10 | TXCLK/50M_CLKI | REF_CLK_PHY |
| 11 | LED0/PHY_AD0 | PHY_LED0_AD0 |
| 12 | LED3/PHY_AD3 | PHY_LED3_AD3 |
| 13 | VDDIO | PHY_3V3 |
| 14 | RXCLK/50M_CLKO | PHY_50M_CLKO |
| 15 | RXD3 | NC |
| 16 | RXD2 | NC |
| 17 | RXD1 | PHY_RXD1 |
| 18 | RXD0 | PHY_RXD0 |
| 19 | RXDV/CRS_DV/FX_HEN | PHY_CRS_DV |
| 20 | CRS/LEDMOD | PHY_LEDMOD |
| 21 | RXER/INTR_32 | NC |
| 22 | MDC | MDC |
| 23 | MDIO | MDIO |
| 24 | TEST_ON | NC |
| 25 | ISET | PHY_ISET |
| 26 | MDI_RN | MDI_RN |
| 27 | MDI_RP | MDI_RP |
| 28 | REGOUT | PHY_REGOUT |
| 29 | MDI_TN | MDI_TN |
| 30 | MDI_TP | MDI_TP |
| 31 | AVDD33 | PHY_3V3 |
| 32 | RESET_N | PHY_RST_N |
| 33 | GND | GND |

## 6. USB

- **HS OTG (UAC2):** the dedicated pads USB_DP (50) and USB_DM (49) [DS Table 2-10].
  The path is USB-C A6/B6 and A7/B7 (both orientations joined at the receptacle) →
  TPD2EUSB30 at the connector → 0R pair placed at the P4 ("reserve space for
  resistors/capacitors close to the chip" [HDG 1.4.3]) → pads. 90 Ω ±10 %
  differential, on top layer over solid GND, minimal vias with return vias at each
  transition [HDG 1.4.3]. A 1 MΩ DP pull-down is footprinted DNP; it was mandatory on
  v1.x and is optional on v3.x [HDG 1.3.12]. There is no REXT or other external part
  for the HS PHY.
- **CC:** 5.1 kΩ Rd on CC1 and CC2 makes the port a UFP sink, so the source supplies
  vSafe5V only. No PD. SBU is NC.
- **VBUS:** TVS → TPS25200. Capacitance ahead of the switch is 1.1 µF, well under the
  10 µF USB 2.0 limit. The eFuse soft start (t_r ≈ 2–3 ms typ [TPS 5.6]) charges about
  15 µF downstream at 15 µF·5 V/2 ms ≈ 40 mA, and the 3V3 buck has its own soft start.
  EN = VBUS/2 (100 k/100 k). Note that the EN abs max is 7 V. A VBUS above 14 V would
  over-stress EN even though IN tolerates 20 V. A UFP without PD only ever receives
  5 V, so rev 1 accepts this (risk R7).
- **USB-Serial-JTAG (FS):** GPIO24 (D−) / GPIO25 (D+) are the default USJ pads [HDG
  1.3.12]. They go only to test pads for production flashing and debug, so the single
  USB-C always carries the UAC2 device. Joint Download (BOOT low) also supports
  "USB 2.0 OTG download at Full-Speed" over the HS port [DS Table 3-3 note]. That makes
  first-time flashing through the USB-C itself possible (UNVERIFIED on v3.x; test on the
  first board).

## 7. Clocks

### 7.1 40 MHz system crystal
40 MHz is the only frequency the firmware supports. Tolerance is ±10 ppm [HDG
1.3.5]. X322540MPB4SI has CL = 15 pF; C = 2·(15 − ~4 pF stray) ≈ 22 pF, to be tuned on
the first build as [HDG] says. A 0R in series on XTAL_P and XTAL_N sits next to the
chip, as R3/R4 in [HDG Fig. 1]. The crystal sits ≥ 4.5 mm from the XTAL pins, with no
vias on the clock traces and nothing routed under it [HDG 1.4.2] (also a DRC rule).

### 7.2 50 MHz RMII reference (decision record)
The requirement is "a 50 MHz oscillator feeding P4 REF_CLK (GPIO50) and the PHY,
exactly as the Waveshare ESP32-P4-ETH". **The Waveshare schematic shows something
different.** [WS] page 1 has a **25 MHz** 4-pin crystal (Y3, 20 pF caps) on IP101 X1/X2.
The PHY's RXCLK/50M_CLKO (pin 14) drives GPIO50 and its own 50M_CLKI (pin 10).
Espressif's [EVX] does the same (25 MHz ±10 ppm crystal, 0R on RMII_CLK). docs/11 §1
("50 MHz from the board oscillator") should be corrected to "from the PHY".

Rev 1 still uses a **separate 50 MHz XO**, as required. This is a valid IP101
configuration: "Clock 50MHz provides a clock source 50MHz into pin TXCLK/50M_CLKI and
connect pin X1 to GND" [IP Table 3, pin 2]. It has three advantages:
1. REF_CLK runs regardless of PHY state. With the PHY-sourced clock, every PHY reset
   (GPIO51) also stops the EMAC's RX/TX clock. The EMAC DMA soft reset needs that clock
   (a frequently reported "EMAC reset timeout" in ESP-IDF; UNVERIFIED for IDF v6.1).
2. One clock domain with a defined source (±25 ppm XO). The PHY PLL is not part of
   the media-clock path that the 1588 servo disciplines.
3. Firmware is unchanged: `EMAC_CLK_EXT_IN` on GPIO50 either way.

**Fallback by population (DNP option B = the [WS]/[EVX] scheme).** Both schemes are on
the board, and the parts fitted decide which one is active. Firmware is identical
(GPIO50 is a REF_CLK input in both):

| part | option A (default): 50 MHz XO | option B: IP101 25 MHz crystal, PHY drives REF_CLK |
|---|---|---|
| X1 50 MHz XO (+ its 0R/decaps) | fitted | **remove** (or remove its supply 0R) |
| 0R PHY_X1 → GND | fitted (X1 must be GND in 50 MHz-input mode [IP pin 2]) | **remove** |
| Y2 25 MHz crystal on X1/X2 + 2× 20 pF | DNP | **fit** ([WS] Y3, C113/C120 20 pF) |
| 22R PHY_50M_CLKO → OSC50_OUT star | DNP | **fit** |
| 22R star → GPIO50, 22R star → PHY 50M_CLKI | fitted | fitted (unchanged) |

In option B, 50M_CLKO feeds both the MAC and the PHY's own 50M_CLKI through the same
star, as [WS] ties pins 10 and 14 together. The star node is laid out once and serves
either source, so the layout must keep the CLKO stub from pin 14 short. Remember that
in option B, REF_CLK stops whenever the PHY is in reset (risk R5).

The layout must follow the [IP §6.1] note: "the clock trace length to IP101G must equal
the clock trace length to MAC", and jitter < 500 ps p-p. That means a star from the XO
with one 22R per branch at the source, both branches equal (DRC rule: 4–14 mm, ≤ 1
via), and a guard / GND stitch on both sides. RESET_N timing (≥ 10 ms reset, clock
valid ≥ 10 ms before release [IP Table 14]) is met because the PHY is held in reset by
a 10 k pull-down until firmware releases GPIO51. The firmware's pulse is long enough
only if it is ≥ 10 ms (§15).

## 8. Ethernet

- RMII per §5. 22R series at the driver end of all six data lines (TXD0/1, TX_EN at the
  P4; RXD0/1, CRS_DV at the PHY) and on both clock branches [HDG 1.3.14]. RMII timing:
  T_su 4 ns, T_h 2 ns, Td ≤ 12 ns [IP Tables 17/18]. At 50 MHz this is comfortable
  for traces of a few cm; the DRC caps them at 40 mm.
- MDIO 1.5 k pull-up (as [WS] R59); MDC ≤ 2.5 MHz [IP].
- ISET 6.19 kΩ 1 % [IP pin 25] (WS uses 6.2 k). REGOUT 10 µF + 0.1 µF [IP pin 28];
  REGOUT must not feed anything else [IP Table 1 note].
- Magjack centre taps: **decoupling capacitors only, never a supply**. IP101G is a
  voltage-mode driver with built-in 49.9 Ω terminations ("Center-tap of transformer:
  Do not connect to any power" [IP Table 1]; "connected to decoupling capacitors
  respectively" [IP §6.2]). Rev 1 uses 100 nF on TCT and on RCT separately. [WS] ties
  both to one 22 nF.
- Bob-Smith node (HR911105A pin 8) and shield go to CHASSIS. CHASSIS connects to GND
  through 1 MΩ ∥ 10 nF/100 V, plus a DNP 0R for a hard tie if EMC testing prefers it.
  [IP §6.1]: "Place a gap between the system and chassis grounds."
- MDI pairs: 100 Ω differential, as short as possible, with 3× spacing to other nets
  [IP §6.2]. No GND or power plane under the magjack's line side. Only CHASSIS copper
  between the magjack and the board edge.
- HR911105A LED pin polarity is taken from the KiCad symbol (yellow 12 = A / 11 = K,
  green 9 = A / 10 = K). **UNVERIFIED** against the HanRun drawing, because the LCSC
  datasheet link would not download in this environment.

## 9. Stackup and impedance

JLC 4-layer **JLC04161H-3313**, 1.6 mm, ENIG. Thicknesses are UNVERIFIED (from memory
of JLC's published stackup). Re-check them on jlcpcb.com and rerun the JLC impedance
calculator before ordering. Choose controlled impedance at order time.

| layer | use | thickness |
|---|---|---|
| L1 F.Cu | components, all HS USB, RMII, MDI, 40/50 MHz | 35 µm |
| prepreg 3313 | εr ≈ 4.1 | 0.0994 mm |
| L2 In1.Cu | **solid GND, no traces** [HDG 1.4] | 15 µm |
| core | εr ≈ 4.6 | ≈ 1.265 mm |
| L3 In2.Cu | +3V3 pour with VDD_HP / VBUS_5V islands; slow signals only | 15 µm |
| prepreg 3313 | | 0.0994 mm |
| L4 B.Cu | slow signals, GND pour | 35 µm |

Targets. Widths come from Hammerstad-Jensen microstrip and edge-coupled closed-form
models (L1 over L2, h = 0.0994 mm, t = 35 µm, εr 4.1) and are encoded as net classes
(UNVERIFIED until checked with the JLC calculator):

| class | target | geometry | nets |
|---|---|---|---|
| USB_HS_90R | 90 Ω diff ±10 % [HDG 1.4.3] | w 0.15 / gap 0.11 mm | USB_D±, USB_CONN_D± |
| ETH_MDI_100R | 100 Ω diff | w 0.15 / gap 0.20 mm | MDI_TP/TN, MDI_RP/RN |
| RMII_50R | 50 Ω SE | w 0.17 mm | RMII_*, PHY_TX*/RX*, CRS_DV, REF_CLK_*, OSC50_OUT, MDC, MDIO |
| POWER | — | 0.4 mm (3V3 trunk ≥ 25 mil = 0.64 mm, VDD_HP ≥ 20 mil [HDG 1.4.1]) | rails |
| SW_NODE | — | 0.5 mm, short | SW_3V3, SW_HP |

## 10. Layout rules (for the routing pass)

`hardware/kicad/usb-inferno.kicad_dru` encodes the checkable ones.

1. **L2 is unbroken GND** under the whole board except the CHASSIS strip at the
   connector edge. No slots under USB, RMII, the crystal or the XO.
2. **HS USB:** top layer only, pair skew ≤ 0.15 mm, uncoupled length ≤ 2 mm,
   ≤ 2 vias (DRC), with ground return vias next to any via. ESD at the connector, then
   the 0R pair at the chip. Keep the pair away from the SW nodes and the 50/40 MHz
   clocks by ≥ 3w.
3. **RMII:** all lines ≤ 40 mm (DRC); REF_CLK branches equal ± a few mm (DRC window
   4–14 mm); series R at the driver; GND stitching along REF_CLK.
4. **MDI:** 100 Ω pairs, skew ≤ 0.3 mm, PHY close to the magjack.
5. **Crystal:** [HDG 1.4.2]: ≥ 4.5 mm from the chip clock pins, no vias on XTAL
   traces (DRC), caps at the crystal end, GND copper and via fence around it, nothing
   under it, no inductors nearby (L1/L2 are ≥ 10 mm away in the placement).
6. **Decoupling:** 0.1 µF per supply pin, at the pin, through its own via to L2
   [HDG 1.4.1]. Star-feed the P4 rails. 10 µF at VDD_LDO and VDD_DCDCC.
7. **VDD_HP buck** next to the P4 EN_DCDC/FB_DCDC corner. Short input, output and FB
   loops [HDG 1.4.1]. FB sense from the P4 VDD_HP plane side, not the inductor pad.
8. **Thermal pad:** the QFN104 EP has 3×3 Ø0.25 mm vias between the 4×4 paste
   windows (~56 % paste). Order with via-in-pad **resin filled and capped**, or tent
   the vias from the bottom. IP101 uses KiCad's QFN-32 ThermalVias footprint.
9. **Edge:** USB-C and RJ45 overhang the left (short) edge by 0.6 mm (courtyard
   front). Copper keeps ≥ 0.3 mm from the edge.
10. **Fine pitch:** QFN104 has 0.35 mm pitch, 0.20 mm pads and a 0.15 mm gap.
    Net-class clearances are 0.15 mm so escape works. Check JLC's assembly capability
    for 0.35 mm QFN (UNVERIFIED) and use a 0.1 mm stencil.

## 11. Placement plan (implemented in `hardware/tools/make_pcb.py`)

Board **60 × 40 mm**, 4 × M2 plated holes to CHASSIS. Coordinates are mm from the
top-left corner.

```
 x=0 (panel edge)                                                    x=60
 +-------------------------------------------------------------------+
 | USB-C J1   U2 eFuse  U3+L1 3V3 buck        H1          H2         |
 |  (y 4-13)  D1 ESD D2 TVS               U5 flash (49,9)            |
 | D3 LED (status, visible on panel)                                 |
 | RJ45 J2      U6 IP101 (24.5,24.5)   U1 ESP32-P4 (38,20) rot 180   J3 TC2030 (55,20)
 |  (y 18-40)   X1 50 MHz (31,29.5) Y2 25M DNP (25.5,30.8) Y1 40 MHz (45.5,30)           |
 |              H4   U4+L2 VDD_HP buck (33.5,34.5)  TP row (44-52,35) H3
 +-------------------------------------------------------------------+
```

U1 is rotated 180°. Its RMII pins (original right side and top-right corner) then face
the PHY and the connectors. The HS USB pads (original bottom-right) end up at the
top-left corner, nearest the USB-C. The flash pins (original bottom-left) face U5,
and the XTAL pins sit at the bottom-right, away from RMII. All passives are staged
outside the outline, in columns labelled "for U1", "for U6", … on Cmts.User. The
layout pass moves them to their ICs. The free area at the right and bottom-right
(≈ 14 × 16 mm) is the PoE reserve (§14).

## 12. ESD / EMI

- USB D±: TPD2EUSB30 (IEC 61000-4-2 level 4 contact [TPD]) at the receptacle, ≤ 1 pF.
- VBUS: SMAJ5.0A + eFuse OVLO; CC lines rely on the receptacle and the 5.1 k Rd (an
  ESD diode option is not footprinted; consider it for rev 2).
- Ethernet: the magjack's isolation (1500 Vrms class, UNVERIFIED for HR911105A), Bob-Smith
  to CHASSIS. IP101G itself is rated ±12 kV contact / ±15 kV air IEC 61000-4-2 [IP 7.1].
- Clocks: series R at the source, short and guarded traces, XO supply via 0R (fit a
  ferrite if spurs appear). FLASH_CK has a 0R + 22 pF (DNP) RC option [HDG 1.3.7].
- Chassis tie: 1 M ∥ 10 nF, with a hard-tie 0R option.

## 13. Programming and debug

TC2030-IDC-NL footprint (no legs, no BOM part). Pins: 1 3V3 · 2 EN (CHIP_PU) · 3 GND ·
4 U0TXD (GPIO37) · 5 U0RXD (GPIO38) · 6 BOOT (GPIO35). The host adapter must not
back-power 3V3 when the board is USB powered (sense only). Test pads: USJ_D+ (GPIO25),
USJ_D− (GPIO24), 5V, 3V3, VDD_HP, GND, FAULT (eFuse), IO36. Production flow: BOOT
low + EN pulse → esptool over UART0 or USB-Serial-JTAG pads.

## 14. PoE (not on rev 1)

Rev 2 option: isolated 802.3af PD (e.g. a TPS2378/Si3404-class PD controller with an
active-clamp or flyback to 5 V, ~22 × 16 mm including the 1.5 kV creepage gap).
Its 5 V would be OR-ed with VBUS_5V through an ideal-diode pair (LM66100-class, or
AO3401A + LMBT3906DW discrete as [EVX] page 6 "Ideal Diodes") **after** the eFuse.
This needs a **PoE-rated magjack** with centre taps brought out (HR911105A is not one),
so the RJ45 footprint changes in rev 2. On rev 1 the bottom-right area of the board is
free of parts and is marked on Cmts.User.

## 15. Firmware deltas for this board (all constants, no code)

- `UI_PIN_STATUS_LED 20` (new; active high).
- Build for **chip rev v3.x** (`CONFIG_ESP32P4_SELECTS_REV_LESS_V3=n`, the default in
  IDF ≥ 5.5.3/6.0 [REV3 2.1.2]). [WS] has pin 54 = NC, i.e. **v1.x silicon**, so
  bench boards and this board need **different binaries** [REV3]. `CPU_FREQ_400`
  becomes available.
- Flash stays 16 MB (`CONFIG_ESPTOOLPY_FLASHSIZE_16MB`), 3.3 V QSPI; the firmware uses
  < 4 MB, which leaves room for two OTA/DFU slots (Q7).
- PHY reset pulse ≥ 10 ms low, then ≥ 10 ms before the first MDIO access [IP Table 14].
  Check the generic PHY driver's reset timing.
- `bMaxPower` = 400 mA (descriptor value 200).
- Optional, for compliance: until SET_CONFIGURATION, run the CPU at a low clock and keep GPIO51 low, i.e. the PHY in reset (§3.3).

## 16. Tooling and ERC

SKiDL 2.3.0 works with KiCad 9's symbol libraries, so no alternative was needed. Its
output is a **netlist**, not a `.kicad_sch`. ERC is therefore SKiDL's pin-type ERC
(power-in driven, outputs not shorted, unconnected pins explicitly NC):
**0 errors, 0 warnings** (`hardware/erc.log`). Rails carry `drive = POWER`, which is
the PWR_FLAG equivalent. KiCad's own schematic ERC cannot run without a schematic
sheet. If the team wants a drawn schematic for review, it has to be drawn from the
netlist in Eeschema (SKiDL's schematic generator only supports KiCad 5/6). The PCB is
built with the pcbnew Python API from the netlist (pads ↔ nets) and checked with
`kicad-cli pcb drc`. The only remaining violations are the expected ones for an
unrouted board: unconnected items, silk overlaps of staged parts, and REF_CLK length
(no tracks yet).

## 17. Open risks and unverified items

| # | item | status / action |
|---|---|---|
| R1 | **ESP32-P4NRW32X availability** at LCSC/JLC | no LCSC listing found. Get Espressif distributor stock and consign it, or use JLC global sourcing. The forum report says the X part is in MP |
| R2 | QFN104 land pattern is my derivation from [DS Fig. 6-1] | compare with Espressif's official KiCad/Altium footprint (esp-dev-kits) before release |
| R3 | 0.35 mm pitch QFN + via-in-pad at JLC | confirm capability and price (resin-filled vias) |
| R4 | Impedance geometry from closed-form models; 3313 stackup thicknesses from memory | JLC impedance calculator |
| R5 | 50 MHz XO approach differs from [WS]/[EVX] (25 MHz crystal + PHY clock) | electrically per [IP Table 3]. Fallback footprinted: option B (§7.2) is selected by population only. In option B the clock stops during PHY reset |
| R6 | Passive LCSC numbers marked `recall`; 499 k and 6.19 k `TBD`; SMAJ5.0A and LED `recall` | JLC BOM tool |
| R7 | TPS25200 EN abs max 7 V vs 100 k/100 k from VBUS | fine for vSafe5V; a 5.1 V zener on EN for rev 2 |
| R8 | Unconfigured-device current about 195 mA (> 100 mA) | measure; firmware can delay Ethernet start until USB is configured if a host objects |
| R9 | HR911105A LED pinout from the KiCad symbol, not the HanRun drawing | check the drawing |
| R10 | USB OTG (HS port) download at FS in Joint Download mode on v3.x | test on the first board; the Tag-Connect UART is the fallback |
| R11 | Thermal: P4 + PHY ≈ 1 W in a closed box | EP vias + L2/L4 GND pour; measure |
| R12 | P4 current figures (+60 mA traffic estimate) | measure on the Waveshare board (roadmap B8) |
| R13 | [IP] is a 2012 preliminary data sheet from a mirror | ask IC Plus/WIZnet for the current IP101GRI data sheet |
| R14 | 40 MHz load caps (22 pF) | tune frequency on the first board [HDG] |

## 18. What remains for the human layout pass

1. Move the staged passives (right of the outline, grouped by IC) next to their pins
   (decoupling first), following §10.
2. Route, in this order: VDD_HP buck → P4 power → HS USB pair → RMII + REF_CLK star
   → MDI → crystal → flash QSPI → the rest. Then add VDD_HP / VBUS_5V islands to the L3
   pour and stitch GND.
3. Fill the zones, run DRC (it must then be clean apart from Cmts), and set JLC
   controlled impedance with the §9 stackup.
4. Add silkscreen: polarity, the USB/ETH legends, the Tag-Connect outline and the
   board name.
5. Generate fabrication outputs (Gerbers, drill, CPL) and a JLC-format BOM from
   `hardware/bom.csv`.
