DrEVILish/inferno-esp32-usb/docs/img/board-rev1-placement.png

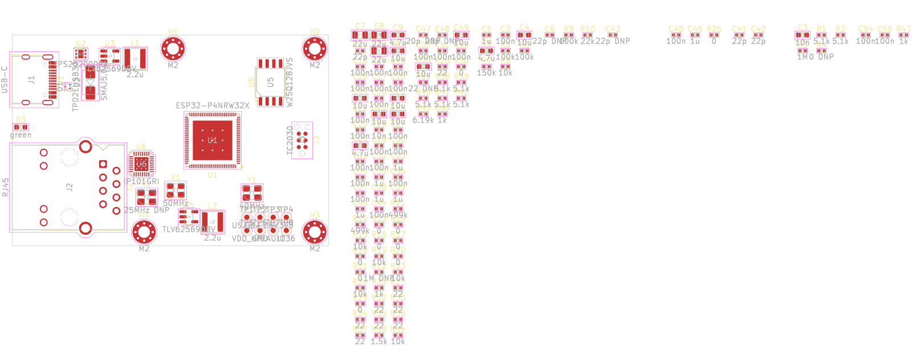
docs/img/board-rev1-placement.png
