DrEVILish/inferno-esp32-usb/hardware/bom.csv

ref | value | description | MPN | manufacturer | LCSC | LCSC_status | footprint | qty | dnp
C2 C13 C14 C15 C16 C17 C18 C20 C22 C25 C27 C29 C30 C31 C32 C34 C36 C37 C44 C45 C50 C51 C52 C54 C55 | 100n | 100nF 16V X7R 0402 | CL05B104KO5NNNC | Samsung | C1525 | recall | Capacitor_SMD:C_0402_1005Metric | 25
C3 | 10n | 10nF 100V X7R 0603 (chassis bleed) | CL10B103KC8NNNC | Samsung | C1589 | recall | Capacitor_SMD:C_0603_1608Metric | 1
C26 | 10n | 10nF 50V X7R 0402 | CL05B103KB5NNNC | Samsung | C15195 | recall | Capacitor_SMD:C_0402_1005Metric | 1
C4 C12 C19 C21 C23 C24 C49 C53 | 10u | 10uF 10V X5R 0603 | CL10A106KP8NNNC | Samsung | C19702 | recall | Capacitor_SMD:C_0603_1608Metric | 8
C1 C33 C35 C38 C39 C40 C46 | 1u | 1uF 25V X5R 0402 | CL05A105KA5NQNC | Samsung | C52923 | recall | Capacitor_SMD:C_0402_1005Metric | 7
C47 C48 | 20p DNP | 20pF 50V C0G 0402 | 0402CG200J500NT | FH | C1554 | recall | Capacitor_SMD:C_0402_1005Metric | 2 | DNP
C10 C41 C42 | 22p | 22pF 50V C0G 0402 | 0402CG220J500NT | FH | C1555 | recall | Capacitor_SMD:C_0402_1005Metric | 3
C6 C43 | 22p DNP | 22pF 50V C0G 0402 | 0402CG220J500NT | FH | C1555 | recall | Capacitor_SMD:C_0402_1005Metric | 2 | DNP
C7 C8 C11 | 22u | 22uF 25V X5R 0805 | CL21A226MAQNNNE | Samsung | C45783 | recall | Capacitor_SMD:C_0805_2012Metric | 3
C5 C9 C28 | 4.7u | 4.7uF 16V X5R 0603 | CL10A475KO8NNNC | Samsung | C19666 | recall | Capacitor_SMD:C_0603_1608Metric | 3
D2 | SMAJ5.0A | TVS 5.0 V standoff, 400 W, SMA | SMAJ5.0A | Littelfuse | C83329 | recall | Diode_SMD:D_SMA | 1
D1 | TPD2EUSB30 | 2-ch ESD for USB HS/SS, 0.7 pF | TPD2EUSB30DRTR | Texas Instruments | C97502 | checked | Package_TO_SOT_SMD:Texas_DRT-3 | 1
D3 | green | LED green 0603 | 19-217/GHC-YR1S2/3T | Everlight | C72043 | recall | LED_SMD:LED_0603_1608Metric | 1
J2 | RJ45 | RJ45 magjack 10/100 with LEDs | HR911105A | HanRun | C12074 | checked | Connector_RJ:RJ45_Hanrun_HR911105A_Horizontal | 1
J1 | USB-C | USB-C receptacle 16P, USB 2.0, SMD/THT shell | TYPE-C-31-M-12 | Korean Hroparts Elec | C165948 | checked | Connector_USB:USB_C_Receptacle_HRO_TYPE-C-31-M-12 | 1
L1 L2 | 2.2u | 2.2uH 3.7A Isat 4x4mm | FNR4020S2R2MT | cjiang (Changjiang Microelectronics) | C167825 | checked | Inductor_SMD:L_Changjiang_FNR4020S | 2
R13 R14 R16 R17 R18 R20 R21 R26 R29 R30 | 0 | 0R 0402 | 0402WGF0000TCE | UNI-ROYAL | C17168 | recall | Resistor_SMD:R_0402_1005Metric | 10
R4 | 0 DNP | 0R 0402 | 0402WGF0000TCE | UNI-ROYAL | C17168 | recall | Resistor_SMD:R_0402_1005Metric | 1 | DNP
R43 | 1.5k | 1.5k 1% 0402 | 0402WGF1501TCE | UNI-ROYAL | C25867 | recall | Resistor_SMD:R_0402_1005Metric | 1
R5 R6 R9 | 100k | 100k 1% 0402 | 0402WGF1003TCE | UNI-ROYAL | C25741 | recall | Resistor_SMD:R_0402_1005Metric | 3
R8 R15 R19 R23 R24 R44 | 10k | 10k 1% 0402 | 0402WGF1002TCE | UNI-ROYAL | C25744 | recall | Resistor_SMD:R_0402_1005Metric | 6
R7 | 150k | 150k 1% 0402 | 0402WGF1503TCE | UNI-ROYAL | C25755 | recall | Resistor_SMD:R_0402_1005Metric | 1
R3 | 1M | 1M 1% 0402 | 0402WGF1004TCE | UNI-ROYAL | C26083 | recall | Resistor_SMD:R_0402_1005Metric | 1
R22 | 1M DNP | 1M 1% 0402 | 0402WGF1004TCE | UNI-ROYAL | C26083 | recall | Resistor_SMD:R_0402_1005Metric | 1 | DNP
R25 R46 R47 | 1k | 1k 1% 0402 | 0402WGF1001TCE | UNI-ROYAL | C11702 | recall | Resistor_SMD:R_0402_1005Metric | 3
R27 R28 R32 R33 R34 R35 R36 R37 | 22 | 22R 1% 0402 | 0402WGF220JTCE | UNI-ROYAL | C25092 | recall | Resistor_SMD:R_0402_1005Metric | 8
R31 | 22 DNP | 22R 1% 0402 | 0402WGF220JTCE | UNI-ROYAL | C25092 | recall | Resistor_SMD:R_0402_1005Metric | 1 | DNP
R10 | 22k | 22k 1% 0402 | 0402WGF2202TCE | UNI-ROYAL | C25768 | recall | Resistor_SMD:R_0402_1005Metric | 1
R11 R12 | 499k | 499k 1% 0402 (VDD_HP FB, [HDG] Fig. 5) | 0402WGF4993TCE | UNI-ROYAL |  | TBD | Resistor_SMD:R_0402_1005Metric | 2
R1 R2 R38 R39 R40 R41 R42 | 5.1k | 5.1k 1% 0402 | 0402WGF5101TCE | UNI-ROYAL | C25905 | recall | Resistor_SMD:R_0402_1005Metric | 7
R45 | 6.19k | 6.19k 1% 0402 (IP101 ISET) | 0402WGF6191TCE | UNI-ROYAL |  | TBD | Resistor_SMD:R_0402_1005Metric | 1
U1 | ESP32-P4NRW32X | ESP32-P4 rev v3.x, 32MB PSRAM in package, QFN104 | ESP32-P4NRW32X | Espressif Systems |  | TBD | usb_inferno:Espressif_QFN-104-1EP_10x10mm_P0.35mm_EP7.5x7.5mm | 1
U6 | IP101GRI | 10/100 Ethernet PHY RMII QFN32 4x4 | IP101GRI | IC Plus | C703537 | checked | Package_DFN_QFN:QFN-32-1EP_4x4mm_P0.4mm_EP2.65x2.65mm_ThermalVias | 1
U3 U4 | TLV62569DBV | 2A 1.5MHz sync buck | TLV62569DBVR | Texas Instruments | C141836 | checked | Package_TO_SOT_SMD:SOT-23-5 | 2
U2 | TPS25200DRV | 5V eFuse 20V-tolerant, soft start, adj. current limit | TPS25200DRVR | Texas Instruments | C128401 | checked | Package_SON:WSON-6-1EP_2x2mm_P0.65mm_EP1x1.6mm | 1
U5 | W25Q128JVS | 128Mbit QSPI NOR 3.3V SOIC-8 208mil | W25Q128JVSIQ | Winbond | C97521 | checked | Package_SO:SOIC-8_5.3x5.3mm_P1.27mm | 1
X1 | 50MHz | 50MHz CMOS XO 1.62-3.63V +-25ppm 3225 (clock option A; remove for B) | ECS-3225MV-500-CN-TR | ECS Inc. | C405974 | checked | Oscillator:Oscillator_SMD_Abracon_ASE-4Pin_3.2x2.5mm | 1
Y2 | 25MHz DNP | 25MHz 3225 crystal, PHY clock option B (fit for B) | X322525MSB4SI | YXC | C13740 | checked | Crystal:Crystal_SMD_3225-4Pin_3.2x2.5mm | 1 | DNP
Y1 | 40MHz | 40MHz 15pF +-10ppm 3225 | X322540MPB4SI | YXC | C9010 | checked | Crystal:Crystal_SMD_3225-4Pin_3.2x2.5mm | 1
