DrEVILish/inferno-esp32-usb/hardware/kicad/usb-inferno.kicad_pcb

## KiCad design hardware/kicad/usb-inferno.kicad_pcb (2026-10-14)

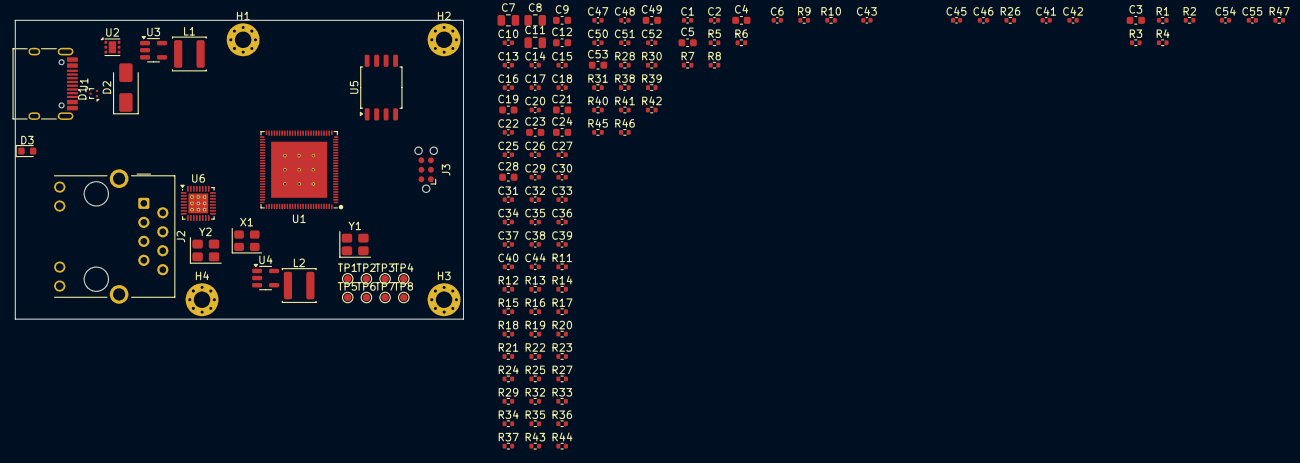
[picture p2: board usb-inferno.kicad_pcb from above]

Board: 4 copper layers, 60.0 x 40.0 mm, 131 parts (0 on the bottom side), 83 nets, no tracks yet.

Parts:
C1, C33, C35, C38, C39, C40, C46: 1u; C_0402_1005Metric
C2, C13, C14, C15, C16, C17, C18, C20, C22, C25, C27, C29, C30, C31, C32, C34, C36, C37, C44, C45, C50, C51, C52, C54, C55: 100n; C_0402_1005Metric
C3: 10n; C_0603_1608Metric
C4, C12, C19, C21, C23, C24, C49, C53: 10u; C_0603_1608Metric
C5, C9, C28: 4.7u; C_0603_1608Metric
C6, C43: 22p DNP; C_0402_1005Metric
C7, C8, C11: 22u; C_0805_2012Metric
C10, C41, C42: 22p; C_0402_1005Metric
C26: 10n; C_0402_1005Metric
C47, C48: 20p DNP; C_0402_1005Metric
D1: TPD2EUSB30; Texas_DRT-3
D2: SMAJ5.0A; D_SMA
D3: green; LED_0603_1608Metric
H1, H2, H3, H4: M2; MountingHole_2.2mm_M2_Pad_Via
J1: USB-C; USB_C_Receptacle_HRO_TYPE-C-31-M-12
J2: RJ45; RJ45_Hanrun_HR911105A_Horizontal
J3: TC2030; Tag-Connect_TC2030-IDC-NL_2x03_P1.27mm_Vertical
L1, L2: 2.2u; L_Changjiang_FNR4020S
R1, R2, R38, R39, R40, R41, R42: 5.1k; R_0402_1005Metric
R3: 1M; R_0402_1005Metric
R4: 0 DNP; R_0402_1005Metric
R5, R6, R9: 100k; R_0402_1005Metric
R7: 150k; R_0402_1005Metric
R8, R15, R19, R23, R24, R44: 10k; R_0402_1005Metric
R10: 22k; R_0402_1005Metric
R11, R12: 499k; R_0402_1005Metric
R13, R14, R16, R17, R18, R20, R21, R26, R29, R30: 0; R_0402_1005Metric
R22: 1M DNP; R_0402_1005Metric
R25, R46, R47: 1k; R_0402_1005Metric
R27, R28, R32, R33, R34, R35, R36, R37: 22; R_0402_1005Metric
R31: 22 DNP; R_0402_1005Metric
R43: 1.5k; R_0402_1005Metric
R45: 6.19k; R_0402_1005Metric
TP1: USJ_D+; TestPoint_Pad_D1.0mm
TP2: USJ_D-; TestPoint_Pad_D1.0mm
TP3: 5V; TestPoint_Pad_D1.0mm
TP4: 3V3; TestPoint_Pad_D1.0mm
TP5: VDD_HP; TestPoint_Pad_D1.0mm
TP6: GND; TestPoint_Pad_D1.0mm
TP7: FAULT; TestPoint_Pad_D1.0mm
TP8: IO36; TestPoint_Pad_D1.0mm
U1: ESP32-P4NRW32X; Espressif_QFN-104-1EP_10x10mm_P0.35mm_EP7.5x7.5mm
U2: TPS25200DRV; WSON-6-1EP_2x2mm_P0.65mm_EP1x1.6mm
U3, U4: TLV62569DBV; SOT-23-5
U5: W25Q128JVS; SOIC-8_5.3x5.3mm_P1.27mm
U6: IP101GRI; QFN-32-1EP_4x4mm_P0.4mm_EP2.65x2.65mm_ThermalVias
X1: 50MHz; Oscillator_SMD_Abracon_ASE-4Pin_3.2x2.5mm
Y1: 40MHz; Crystal_SMD_3225-4Pin_3.2x2.5mm
Y2: 25MHz DNP; Crystal_SMD_3225-4Pin_3.2x2.5mm

Connections:
+3V3: C6.1, C7.1, C8.1, C9.1, C13.1, C14.1, C15.1, C16.1, C17.1, C18.1, C19.1, C20.1, C21.1, C22.1, C23.1, J3.1, L1.2, R8.2, R9.1, R13.1, R14.1, R15.1, R23.1, R24.1, R29.1, TP4.1, U1.9, U1.21, U1.62, U1.75, U1.77, U1.85, U1.96, U1.101, U4.4
CC1: J1.A5, R1.1
CC2: J1.B5, R2.1
CHASSIS: C3.1, H1.1, H2.1, H3.1, H4.1, J1.S1, J2.8, J2.SH, R3.1, R4.1
CHIP_PU: C40.1, J3.2, R15.2, U1.103
EFUSE_EN: R5.2, R6.1, U2.4
EFUSE_FAULT_N: R8.1, TP7.1, U2.3
EFUSE_ILIM: R7.1, U2.2
EN_DCDC: U1.79, U4.1
FB_3V3: C6.2, R9.2, R10.1, U3.5
FB_DCDC: C10.2, R11.2, R12.1, U1.78, U4.5
FLASH_CK: C43.1, R18.2, U5.6
FLASH_CK_P4: R18.1, U1.32
FLASH_CS: R19.2, U1.27, U5.1
FLASH_D: U1.33, U5.5
FLASH_HOLD: U1.31, U5.7
FLASH_Q: U1.28, U5.2
FLASH_WP: U1.29, U5.3
GND: C1.2, C2.2, C3.2, C4.2, C5.2, C7.2, C8.2, C9.2, C11.2, C12.2, C13.2, C14.2, C15.2, C16.2, C17.2, C18.2, C19.2, C20.2, C21.2, C22.2, C23.2, C24.2, C25.2, C26.2, C27.2, C28.2, C29.2, C30.2, C31.2, C32.2, C33.2, C34.2, C35.2, C36.2, C37.2, C38.2, C39.2, C40.2, C41.2, C42.2, C43.2, C44.2, C45.2, C46.2, C47.2, C48.2, C49.2, C50.2, C51.2, C52.2, C53.2, C54.2, C55.2, D1.3, D2.2, D3.1, J1.A1, J1.A12, J1.B1, J1.B12, J3.3, R1.2, R2.2, R3.2, R4.2, R6.2, R7.2, R10.2, R12.2, R22.2, R30.2, R38.2, R42.2, R44.2, R45.2, R47.2, TP6.1, U1.105, U2.5, U2.7, U3.2, U4.2, U5.4, U6.6, U6.7, U6.33, X1.2, Y1.2, Y1.4, Y2.2, Y2.4
GPIO36: R24.2, TP8.1, U1.68
LED_STATUS: R25.1, U1.22
LED_STATUS_A: D3.2, R25.2
MAG_LEDG_K: J2.10, R47.1
MAG_LEDY_K: J2.11, R46.1
MAG_RCT: C55.1, J2.5
MAG_TCT: C54.1, J2.4
MDC: U1.61, U6.22
MDIO: R43.2, U1.95, U6.23
MDI_RN: J2.6, U6.26
MDI_RP: J2.3, U6.27
MDI_TN: J2.2, U6.29
MDI_TP: J2.1, U6.30
OSC50_OUT: R27.1, R28.1, R31.2, X1.3
OSC50_VDD: C45.1, C46.1, R26.2, X1.1, X1.4
PHY_3V3: C51.1, C52.1, C53.1, J2.12, R26.1, R29.2, R39.1, R40.1, R41.1, R43.1, U6.13, U6.31
PHY_50M_CLKO: R31.1, U6.14
PHY_COL_RMII: R39.2, U6.4
PHY_CRS_DV: R37.1, U6.19
PHY_ISET: R45.1, U6.25
PHY_LED0_AD0: R41.2, R46.2, U6.11
PHY_LED3_AD3: J2.9, R42.1, U6.12
PHY_LEDMOD: R40.2, U6.20
PHY_REGOUT: C49.1, C50.1, U6.28
PHY_RST_N: R44.1, U1.94, U6.32
PHY_RXD0: R35.1, U6.18
PHY_RXD1: R36.1, U6.17
PHY_TXD0: R33.2, U6.9
PHY_TXD1: R34.2, U6.8
PHY_TXEN: R32.2, U6.5
PHY_TXER: R38.1, U6.1
PHY_X1: C47.1, R30.1, U6.2, Y2.1
PHY_X2: C48.1, U6.3, Y2.3
REF_CLK_MAC: R27.2, U1.93
REF_CLK_PHY: R28.2, U6.10
RMII_CRS_DV: R37.2, U1.57
RMII_RXD0: R35.2, U1.58
RMII_RXD1: R36.2, U1.60
RMII_TXD0: R33.1, U1.65
RMII_TXD1: J3.6, R23.2, R34.1, U1.66
RMII_TX_EN: R32.1, U1.92
SW_3V3: L1.1, U3.3
SW_HP: L2.1, U4.3
U0RXD: J3.5, U1.70
U0TXD: J3.4, U1.69
USB_CONN_D+: D1.1, J1.A6, J1.B6, R20.1
USB_CONN_D-: D1.2, J1.A7, J1.B7, R21.1
USB_D+: R20.2, R22.1, U1.50
USB_D-: R21.2, U1.49
USJ_DM: TP2.1, U1.52
USJ_DP: TP1.1, U1.53
VBUS_5V: C4.1, C5.1, TP3.1, U2.1, U3.1, U3.4
VBUS_C: C1.1, C2.1, D2.1, J1.A4, J1.A9, J1.B4, J1.B9, R5.1, U2.6
VDDO_3: C38.1, U1.73
VDDO_4: C39.1, U1.74
VDDO_FLASH: C33.1, C34.1, C44.1, R19.1, U1.30, U1.71, U5.8
VDDO_PSRAM: C35.1, C36.1, C37.1, U1.59, U1.67, U1.72
VDD_BAT: C24.1, C25.1, R13.2, U1.102
VDD_HP: C10.1, C11.1, C12.1, C29.1, C30.1, C31.1, C32.1, L2.2, R11.1, TP5.1, U1.26, U1.54, U1.76, U1.91
VDD_USBPHY: C26.1, C27.1, C28.1, R14.2, U1.51
XTAL_IN: C41.1, R16.2, Y1.1
XTAL_N: R17.1, U1.99
XTAL_OUT: C42.1, R17.2, Y1.3
XTAL_P: R16.1, U1.100
