DrEVILish/inferno-esp32-usb/firmware/main/aoip/info_mcast.c

// SPDX-License-Identifier: GPL-3.0-or-later
//
// Info multicasts and heartbeat. Translated from Inferno
// device_server/info_mcast_server.rs and protocol/mcast.rs.
//
//   to 224.0.0.231:8702 (from port 8700): board info, product info, network
//       info, clock stats, channel-change notifications, reply 0x78
//   to 224.0.0.233:8708: heartbeat, once a second
//   unicast requests arrive on port 8700 (opcode in bytes 24..31)
#include <math.h>
#include <stdio.h>
#include <string.h>
#include "freertos/FreeRTOS.h"
#include "freertos/queue.h"
#include "esp_log.h"
#include "lwip/sockets.h"

#include "app_config.h"
#include "audio/ring.h"
#include "clock/mediaclock.h"
#include "aoip/aoip_internal.h"
#include "aoip/proto.h"
#include "aoip/wire.h"

static const char *TAG = "aoip_info";

static int s_sock = -1;
static uint16_t s_seq = 1;
static QueueHandle_t s_notify_q;
static uint8_t s_pkt[1500];

void info_set_socket(int sock)
{
    s_sock = sock;
    if (!s_notify_q) s_notify_q = xQueueCreate(32, sizeof(uint32_t));
}

static void put_str(uint8_t *buf, size_t off, size_t max, const char *s)
{
    // write_str_to_buffer: copy min(max, len) bytes, no terminator
    size_t n = strlen(s);
    if (n > max) n = max;
    memcpy(buf + off, s, n);
}

static void mc_send(uint32_t dst_host, uint16_t port, uint16_t start_code, const uint8_t opcode[8],
                    const uint8_t *content, size_t n)
{
    if (s_sock < 0 || atomic_load(&g_aoip.ip) == 0) return;
    if (MC_HEADER_LEN + n > sizeof s_pkt) return;
    uint8_t *p = s_pkt;
    wr16(p + 0, start_code);
    wr16(p + 2, (uint16_t)(MC_HEADER_LEN + n));
    wr16(p + 4, s_seq);
    wr16(p + 6, g_aoip.process_id);
    memcpy(p + 8, g_aoip.devid, 8);
    memset(p + 16, ' ', 8);                  // vendor: [32; 8] then the string
    put_str(p, 16, 8, AOIP_VENDOR_STRING);
    memcpy(p + 24, opcode, 8);
    if (n) memcpy(p + MC_HEADER_LEN, content, n);
    s_seq = (uint16_t)(s_seq + 1u);
    struct sockaddr_in a = {
        .sin_family = AF_INET,
        .sin_port = htons(port),
        .sin_addr.s_addr = htonl(dst_host),
    };
    sendto(s_sock, p, MC_HEADER_LEN + n, 0, (struct sockaddr *)&a, sizeof a);
}

static void send_info(const uint8_t opcode[8], const uint8_t *content, size_t n)
{
    mc_send(AOIP_MCAST_DEVICE_INFO, AOIP_PORT_INFO_DST, MC_START_CODE_INFO, opcode, content, n);
}

static void product_version(uint8_t out[4])
{
    // Inferno sends its crate version [major, minor, H(patch), L(patch)].
    unsigned maj = 0, min = 0, pat = 0;
    sscanf(UI_FW_VERSION, "%u.%u.%u", &maj, &min, &pat);
    out[0] = (uint8_t)maj;
    out[1] = (uint8_t)min;
    out[2] = (uint8_t)(pat >> 8);
    out[3] = (uint8_t)pat;
}

static void send_board_info(void)
{
    static uint8_t c[MC_BOARD_INFO_LEN];
    memset(c, 0, sizeof c);
    const uint8_t fw[4] = { 4, 1, 0, 6 }, hw[4] = { 4, 1, 0, 3 }, boot[4] = { 1, 0, 0, 0 };
    memcpy(c + 0, fw, 4);       // firmware version
    c[0x23] = 2;
    memcpy(c + 4, hw, 4);       // hardware version
    c[0x27] = 1;
    memcpy(c + 0x28, boot, 4);  // boot version
    // feature flags: 0x16 = 0x10 "has Manufacturer name"; nothing else
    // (no AES67, not lockable, no sample-rate/encoding configuration).
    c[0x14] = 0;
    c[0x15] = 0;
    c[0x16] = 0x10;
    c[0x17] = 0;
    c[0xbb] = 0x1f;             // "if 0, device is flooded with info multicast requests"
    put_str(c, 12, 8, AOIP_BOARD_NAME);
    put_str(c, 0x38, 16, AOIP_BOARD_NAME);
    const uint8_t op[8] = MC_OP_BOARD_INFO;
    send_info(op, c, sizeof c);
}

static void send_product_info(void)
{
    static uint8_t c[MC_PRODUCT_INFO_LEN];
    memset(c, 0, sizeof c);
    put_str(c, 0, 8, UI_MANUFACTURER);
    put_str(c, 8, 8, AOIP_BOARD_NAME);
    put_str(c, 0x2c, 16, UI_MANUFACTURER);
    put_str(c, 0xac, 16, UI_MODEL_NAME);
    product_version(c + 0x1c);
    const uint8_t op[8] = MC_OP_PRODUCT_INFO;
    send_info(op, c, sizeof c);
}

static void send_capability_status(const uint8_t op[8], uint32_t current, uint16_t update_mode)
{
    // fork capability_status_content: u16 0x0018, u16 count, u32 current,
    // u32 requested (= current: no change is ever pending on this fixed
    // device), u16 update mode, u16 0, then the supported values.
    // Single-value lists: the running rate / width only.
    uint8_t c[16 + 4];
    bb_t bb;
    bb_init(&bb, c, sizeof c);
    bb_u16(&bb, 0x18);
    bb_u16(&bb, 1);
    bb_u32(&bb, current);
    bb_u32(&bb, current);
    bb_u16(&bb, update_mode);
    bb_u16(&bb, 0);
    bb_u32(&bb, current);
    send_info(op, c, bb.len);
}

static void send_sample_rate_status(void)
{
    const uint8_t op[8] = MC_OP_CAP_RATE;
    send_capability_status(op, UI_SAMPLE_RATE, 0);   // SAMPLE_RATE_UPDATE_MODE
}

static void send_encoding_status(void)
{
    const uint8_t op[8] = MC_OP_CAP_ENC;
    send_capability_status(op, UI_NET_BITS, 1);      // ENCODING_UPDATE_MODE
}

void info_send_board_and_product(void)
{
    send_board_info();
    send_product_info();
    // Capability statuses, announced unprompted like the fork: requested =
    // current (no change is ever pending on this fixed device).
    send_sample_rate_status();
    send_encoding_status();
}

static void send_clock_stats(void)
{
    uint8_t id[8];
    mc_leader_id(id);
    static const uint8_t zero[8];
    // Inferno answers only when it knows the leader.
    if (memcmp(id, zero, 8) == 0) return;
    // fork CLOCK_STATUS_TEMPLATE (188 B): sync state, slave port states,
    // flags, freq offset, MACs, leader, port records, EUI-64 identities.
    static const uint8_t tmpl[188] = {
        0x00, 0x02, 0x00, 0x09, 0x00, 0x00, 0x00, 0x9f,
        0x00, 0x00, 0x00, 0x00, 0x00, 0x00, 0x00, 0x00, // 0x00
        0x00, 0x00, 0x00, 0x00, 0x00, 0x00, 0x00, 0x00,
        0x00, 0x00, 0x00, 0x00, 0x00, 0x00, 0x00, 0x00, // 0x10
        0x00, 0x00, 0x00, 0x00, 0x00, 0x01, 0x00, 0x34,
        0x00, 0x09, 0x00, 0x00, 0x02, 0x94, 0x00, 0x00, // 0x20
        0x00, 0x03, 0x0d, 0x40, 0x00, 0x00, 0x00, 0x02,
        0x00, 0x00, 0x00, 0x00, 0x00, 0x00, 0x00, 0x00, // 0x30
        0x00, 0x00, 0x00, 0x00, 0x00, 0x00, 0x00, 0x00,
        0x00, 0x00, 0x00, 0x01, 0x00, 0x60, 0x0c, 0x00, // 0x40
        0x00, 0x00, 0x00, 0x0c, 0x00, 0x98, 0x00, 0x20,
        0x00, 0x03, 0x00, 0x00, 0x00, 0x68, 0x10, 0x00, // 0x50
        0x00, 0x00, 0x00, 0x01, 0x01, 0x02, 0x01, 0x00,
        0x00, 0x00, 0x00, 0x02, 0x00, 0x09, 0x00, 0x07, // 0x60
        0x00, 0x01, 0x00, 0x02, 0x02, 0x02, 0x02, 0x00,
        0x00, 0x00, 0x00, 0x02, 0x00, 0x03, 0x00, 0x03, // 0x70
        0x00, 0x01, 0x00, 0x03, 0x02, 0x02, 0x01, 0x00,
        0x00, 0x00, 0x00, 0x02, 0x00, 0x03, 0x00, 0x07, // 0x80
        0x00, 0x03, 0x00, 0x07, 0x00, 0xb8, 0x00, 0x04,
        0x00, 0x00, 0x00, 0x00, 0x00, 0x00, 0x00, 0x00, // 0x90
        0x00, 0x00, 0x00, 0x00, 0x00, 0x00, 0x00, 0x00,
        0x00, 0x00, 0x00, 0x00, 0x00, 0x00, 0x00, 0x00, // 0xa0
        0x00, 0x01, 0x00, 0x00, 0x00, 0x01, 0x00, 0x00,
        0x00, 0x01, 0x00, 0x00, // 0xb0
    };
    uint8_t c[sizeof tmpl];
    memcpy(c, tmpl, sizeof c);
    // fork build_clock_status: locked follower (3), slave port states (9),
    // flags, freq offset, MAC, leader twice, EUI-64 identities.
    c[0x00] = 0x00; c[0x01] = 0x03;
    c[0x02] = 0x00; c[0x03] = 0x09;
    c[0x28] = 0x00; c[0x29] = 0x09;
    wr32(c + 0x04, 0x9fu);
    wr32(c + 0x08, (uint32_t)mc_freq_ppb());
    memcpy(c + 0x0c, g_aoip.mac, 6);
    memcpy(c + 0x14, id, 8);
    memcpy(c + 0x1c, id, 8);
    c[0x6c] = 0x00; c[0x6d] = 0x09;
    uint8_t own64[8] = { g_aoip.mac[0], g_aoip.mac[1], g_aoip.mac[2], 0xff, 0xfe,
                         g_aoip.mac[3], g_aoip.mac[4], g_aoip.mac[5] };
    uint8_t par64[8] = { id[0], id[1], id[2], 0xff, 0xfe, id[3], id[4], id[5] };
    memcpy(c + 0x98, own64, 8);
    memcpy(c + 0xa0, par64, 8);
    memcpy(c + 0xa8, par64, 8);
    const uint8_t op[8] = MC_OP_CLOCK_STATS;
    send_info(op, c, sizeof c);
}

static void send_network_info(void)
{
    uint8_t c[6 + 2 + 2 + 6 + 4 * 4 + 32];
    bb_t bb;
    bb_init(&bb, c, sizeof c);
    const uint8_t head[6] = { 0x00, 0x01, 0x00, 0x00, 0x00, 0x00 };
    bb_put(&bb, head, 6);
    bb_u16(&bb, 100);           // link speed, Mbit/s (10/100 MAC)
    bb_u16(&bb, 1);
    bb_put(&bb, g_aoip.mac, 6);
    uint32_t ip = atomic_load(&g_aoip.ip);
    bb_put(&bb, &ip, 4);        // network order in memory = wire order
    bb_put(&bb, &g_aoip.netmask, 4);
    bb_put(&bb, &g_aoip.gw, 4);
    bb_put(&bb, &g_aoip.gw, 4); // "DNS? doesn't really matter."
    const uint8_t tail[32] = { 0x00, 0x18, 0x00, 0x30 };
    bb_put(&bb, tail, 32);
    const uint8_t op[8] = MC_OP_NETWORK_INFO;
    send_info(op, c, bb.len);
}

// Info-request rate limit: unauthenticated UDP on port 8700, and every
// answer is a byte-heavy multicast to 224.0.0.231 — a hostile host used to
// be able to elicit them at line rate. Token bucket: one token per 62.5 ms
// (16 answers/s ceiling ≈ 43 kbit/s of multicast), burst 64 so a controller
// polling a few probes at connect is never short of a token.
#define INFO_TOKENS_MAX     64u
#define INFO_TOKEN_MS        62u

static bool info_take_token(void)
{
    static uint32_t tokens = INFO_TOKENS_MAX;
    static uint32_t last_refill_ms;
    const uint32_t now = aoip_now_ms();
    // One token per INFO_TOKEN_MS of elapsed time, fractional time carried
    // in the clock (advance by refill * INFO_TOKEN_MS, not to `now`, so a
    // steady drip never shaves up to one token per refill period). The
    // addition is always clamped: a plain "tokens <= MAX - refill" ternary
    // breaks once refill alone exceeds the burst (any ~4 s idle gap), and
    // then every long idle accumulates unbounded free tokens — the rate
    // limit would silently disarm itself and release a flood on the next
    // request burst.
    const uint32_t refill = (now - last_refill_ms) / INFO_TOKEN_MS;
    if (refill) {
        const uint32_t t = tokens + refill;
        tokens = t >= INFO_TOKENS_MAX ? INFO_TOKENS_MAX : t;
        last_refill_ms += refill * INFO_TOKEN_MS;
    }
    if (tokens == 0) {
        CTR_INC(info_drops);
        return false;
    }
    tokens--;
    return true;
}

void info_on_request(const uint8_t *pkt, size_t len)
{
    if (len < 32) return;
    const uint8_t *o = pkt + 24;
    if (o[0] != 0x07 || o[2] != 0 || o[4] != 0 || o[5] != 0 || o[6] != 0) return;
    if (!info_take_token()) return;
    switch (o[3]) {
    case MC_REQ_BOARD_INFO:
        if (o[7] == 0) send_board_info();
        break;
    case MC_REQ_PRODUCT_INFO:
        if (o[7] == 0) send_product_info();
        break;
    case MC_REQ_CLOCK_STATS:
        send_clock_stats();
        break;
    case MC_REQ_NETWORK_INFO:
        send_network_info();
        break;
    case MC_REQ_77: {
        const uint8_t op[8] = MC_OP_REPLY_78, content[8] = MC_REPLY_78_CONTENT;
        send_info(op, content, sizeof content);
        break;
    }
    case MC_REQ_CAP_RATE:
        send_sample_rate_status();
        break;
    case MC_REQ_CAP_ENC:
        send_encoding_status();
        break;
    default:
        break;
    }
}

void info_notify_rx_channels(uint32_t mask)
{
    if (s_notify_q) xQueueSend(s_notify_q, &mask, 0);
}

static void send_channel_change(uint32_t mask)
{
    // make_channel_change_notification: u16 mask length, then the bitmask
    // (bit i of byte i/8 = channel index i); at least one mask byte.
    uint8_t c[2 + 4] = { 0 };
    unsigned bytes = 1;
    for (unsigned i = 0; i < UI_CHANNELS; i++) {
        if (mask & (1u << i)) {
            c[2 + i / 8] |= (uint8_t)(1u << (i % 8));
            if (i / 8 + 1 > bytes) bytes = i / 8 + 1;
        }
    }
    wr16(c, (uint16_t)bytes);
    const uint8_t op[8] = MC_OP_CHANNEL_CHANGE;
    send_info(op, c, 2 + bytes);
}

void info_poll(void)
{
    uint32_t mask;
    while (s_notify_q && xQueueReceive(s_notify_q, &mask, 0) == pdTRUE) {
        send_channel_change(mask);
    }
}

static uint8_t peak_byte(uint32_t peak)
{
    // peaks.rs: round(-40 * log10(peak / i32::MAX)), clamped to 0..255
    if (peak == 0) return 255;
    float lin = (float)peak / 2147483647.0f;
    float v = roundf(-40.0f * log10f(lin));
    if (v < 0.0f) v = 0.0f;
    if (v > 255.0f) v = 255.0f;
    return (uint8_t)v;
}

static void tx_peaks(uint32_t out[UI_CHANNELS])
{
    memset(out, 0, sizeof(uint32_t) * UI_CHANNELS);
#if CONFIG_USBINF_TEST_TONE
    for (unsigned c = 0; c < UI_CHANNELS; c++) out[c] = 214748364u;   // -20 dBFS
#elif CONFIG_USBINF_TEST_NET_LOOPBACK
    (void)out;  // filled from the RX peaks by the caller
#else
    // Sample the most recent half ring (5 ms) of the TX ring.
    audio_ring_t *r = &g_ring_usb_to_net;
    uint64_t head = atomic_load_explicit(&r->head, memory_order_acquire);
    uint64_t now = mc_now_frames();
    if (head < RING_FRAMES / 2u || head + RING_FRAMES < now || head > now + RING_FRAMES) return;
    for (uint64_t f = head - RING_FRAMES / 2u; f < head; f++) {
        const int32_t *fr = ring_frame(r, f);
        for (unsigned c = 0; c < UI_CHANNELS; c++) {
            int32_t s = fr[c];
            uint32_t a = s < 0 ? (uint32_t)(-(int64_t)s) : (uint32_t)s;
            if (a > out[c]) out[c] = a;
        }
    }
#endif
}

void info_heartbeat(void)
{
    // 88 = 24 + 2 * 32: peaks block for the largest build (>= any UI_CHANNELS)
    static uint8_t c[16 + 88 + 24 + 4 * AOIP_RX_FLOW_SLOTS + 16];
    const uint16_t ctr = s_seq;
    bb_t bb;
    bb_init(&bb, c, sizeof c);

    // 0x8001: frequency offset (ppb). Our clock always exists (it free-runs
    // before PTP lock), so the block is always present.
    bb_u16(&bb, 16);
    bb_u16(&bb, 0x8001);
    bb_u16(&bb, 4);             // ???
    bb_u16(&bb, 4);             // maybe content length???
    bb_u16(&bb, ctr);
    bb_u16(&bb, 0);
    bb_u32(&bb, (uint32_t)mc_freq_ppb());

    // 0x8002: peaks, one byte per channel, TX first then RX
    uint32_t rxp[UI_CHANNELS], txp[UI_CHANNELS];
    frx_take_peaks(rxp);
    tx_peaks(txp);
#if CONFIG_USBINF_TEST_NET_LOOPBACK
    memcpy(txp, rxp, sizeof txp);
#endif
    const unsigned total_peaks = 2u * UI_CHANNELS;
    unsigned total_len = 24u + total_peaks;
    while (total_len % 4u) total_len++;
    uint16_t end_pos = (uint16_t)(bb.wpos + total_len);
    bb_u16(&bb, (uint16_t)(24u + total_peaks));
    bb_u16(&bb, 0x8002);
    bb_u16(&bb, 4);
    bb_u16(&bb, (uint16_t)(12u + total_peaks));
    bb_u16(&bb, ctr);
    bb_u16(&bb, 0);
    bb_u16(&bb, UI_CHANNELS);   // tx peaks count
    bb_u16(&bb, 0);
    bb_u16(&bb, UI_CHANNELS);   // rx peaks count
    bb_u16(&bb, 0);
    bb_u16(&bb, 24);
    bb_u16(&bb, 0);
    for (unsigned i = 0; i < UI_CHANNELS; i++) bb_u8(&bb, peak_byte(txp[i]));
    for (unsigned i = 0; i < UI_CHANNELS; i++) bb_u8(&bb, peak_byte(rxp[i]));
    while (!bb.ovf && bb.wpos < end_pos) bb_u8(&bb, 0);

    // 0x8003: receive latency per RX flow slot (all slots, unused = 0)
    const uint16_t nflows = AOIP_RX_FLOW_SLOTS;
    bb_u16(&bb, (uint16_t)(24u + nflows * 4u));
    bb_u16(&bb, 0x8003);
    bb_u16(&bb, 4);
    bb_u16(&bb, (uint16_t)(12u + nflows * 4u));
    bb_u16(&bb, ctr);
    bb_u16(&bb, 0);
    bb_u16(&bb, nflows);
    bb_u16(&bb, 0);
    bb_u16(&bb, 24);
    bb_u16(&bb, 0);
    bb_u32(&bb, UI_SAMPLE_RATE);
    for (unsigned i = 0; i < nflows; i++) {
        int32_t lat = frx_take_max_latency(i);
        bb_u32(&bb, (uint32_t)(lat < 0 ? 0 : lat));
    }

    if (bb.ovf) {
        ESP_LOGE(TAG, "heartbeat overflow");
        return;
    }
    const uint8_t op[8] = MC_OP_HEARTBEAT;
    mc_send(AOIP_MCAST_HEARTBEAT, AOIP_PORT_HEARTBEAT_DST, MC_START_CODE_HEARTBEAT, op, c, bb.len);
}
