DrEVILish/inferno-esp32-usb/tools/arc_info_host_test.c

// SPDX-License-Identifier: GPL-3.0-or-later
//
// Host test for the fork-comparable AoIP replies, using the REAL firmware
// sources (firmware/main/aoip/arc.c, wire.c, info_mcast.c) with stubbed
// IDF/socket headers (tools/host_stub) and fake device state
// (tools/aoip_host_stubs.c).
//
//   tools/aoip_host_test.sh            build + run, asserts
//   DUMP=1 tools/aoip_host_test.sh    print reply hex for tools/check_vectors.py,
//                                     which compares against the fork sources
//                                     in /tmp/drevinferno (ground truth)
#include <stdint.h>
#include <stdio.h>
#include <stdlib.h>
#include <string.h>

#include "app_config.h"
#include "aoip/aoip_internal.h"
#include "aoip/proto.h"
#include "aoip/wire.h"

// aoip_host_stubs.c capture interface
void host_cap_reset(void);
unsigned host_cap_count(void);
const uint8_t *host_cap_pkt(unsigned i, size_t *len_out);
const uint8_t *host_cap_op(unsigned i);
extern uint8_t host_leader_id[8];
extern int32_t host_freq_ppb;

static int failures;
static int dumping;

static void hexline(const uint8_t *p, size_t n)
{
    for (size_t i = 0; i < n; i++) printf("%02x%s", p[i], i + 1 < n ? " " : "\n");
}

static void check_blob(const char *label, const uint8_t *got, size_t got_n,
                       const uint8_t *want, size_t want_n)
{
    if (dumping) {
        printf("%s:", label);
        hexline(got, got_n);
        return;
    }
    if (got_n != want_n || memcmp(got, want, want_n) != 0) {
        printf("FAIL %s: got %u bytes, want %u bytes\n", label, (unsigned)got_n, (unsigned)want_n);
        printf("  got : ");
        hexline(got, got_n);
        printf("  want: ");
        hexline(want, want_n);
        failures++;
    } else {
        printf("ok %s (%u bytes)\n", label, (unsigned)got_n);
    }
}

// Build an ARC request: header + content. Returns total length.
static size_t mkreq(uint8_t *pkt, uint16_t op, const uint8_t *content, size_t n)
{
    rr_header(pkt, 0x1234, (uint16_t)(RR_HEADER_LEN + n), 7, op, 0);
    if (n) memcpy(pkt + RR_HEADER_LEN, content, n);
    return RR_HEADER_LEN + n;
}

static void test_2204(void)
{
    uint8_t req[32], out[256];
    // fork-observed first-page query content
    const uint8_t q[] = { 0x00, 0x01, 0x00, 0x01, 0x00, 0x00 };
    size_t rl = mkreq(req, 0x2204, q, sizeof q);
    size_t n = arc_handle(req, rl, out, sizeof out);
    const uint8_t want[] = {
        0x12, 0x34, 0x00, 0x0c, 0x00, 0x07, 0x22, 0x04, 0x00, 0x01,
        0x02, 0x00,
    };
    check_blob("arc-2204", out, n, want, sizeof want);
}
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
