DrEVILish/inferno-esp32-usb/(commit log)

2026-10-14 Initial import: ESP32-P4 32x32 AoIP-USB bridge (firmware, docs, hardware, tools)
    Fixed-function 1:1 bridge between 32x32 Inferno-compatible AoIP and
    32x32 USB Audio Class 2.0 (48 kHz, ESP32-P4). Firmware M1-M5, bench
    procedure, rev-1 board sources. Reference clones (third_party/) and
    build outputs stay out via .gitignore.
    [bom.csv, partitions.csv, usb-inferno.kicad_pcb]
2026-10-14 Fix three review findings: mDNS A-record cache, fpp clamp, aoip_lock scope
    - aoip_mdns.c: hostname->IPv4 cache in front of the 3 s query_a fallback;
    32 subscriptions to one badly-announcing host drop from ~100 s to ~3 s.
    - subscriber.c + new aoip/fpp.h: transmitter fpp_min above the MTU cap
    refuses the flow (TX_FAIL) instead of requesting fragmenting packets;
    above only the latency cap it requests the minimum with a warning.
    Pure selection logic host-tested via tools/fpp_select_test.c.
    - aoip_lock: NVS flush and deferred device-rename mDNS republish run
    after the ctl-loop unlock; frx_add/remove_flow socket + quiesce +
    IGMP join/leave outside the lock; rebuild_map unlocked. serve(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
    [aoip.c, aoip_internal.h, aoip_mdns.c, arc.c, flows_rx.c, fpp.h, fpp_select_test.c, subscriber.c]
2026-10-14 Match DrEVILish/inferno controller surface: 0x2204, 0x1100/1101/0x1102, capability + clock info
    - ARC 0x2204 TX flow labels: empty page (02 00), ends per-poll timeouts.
    - ARC 0x1100: six read-only records (rate; default/configured/active =
    profile latency; max 10 ms; min 0.25 ms) with packet-relative offsets.
    - ARC 0x1102: 31-entry property directory, as the fork announces it.
    - ARC 0x1101 writes refused cleanly (0x30): latency is build-time here.
    - Info-mcast: capability 0x80/0x82 at startup + 0x81/0x83 probes
    (requested = current); clock stats use the fork 188 B template
    (locked follower, slave ports, EUI-64 identities).
    - Host tests: tools/aoip_host_test.sh compiles the real arc/wir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
2026-10-14 Perf instrumentation: cycle histograms on hot paths + no-regret micro-opts
    Proposal 1 of docs/15: measurements before optimization.
    - sys/perf.h|c: IRAM-safe cycle-counter probes (8-cycle histograms,
    windowed p50/p99/max via telemetry), wired into rx_input, rx_hook,
    build_and_send/send_raw, and the USB SOF/xfer ISRs.
    - ts_incr.h: packet timestamp (sec, sub) computed once per (re)anchor
    and advanced by fpp with one conditional carry; replaces two 64-bit
    div/mod per TX packet. Host-verified over 800k advance steps.
    - 239/8 membership bitmap (net_group_bit, exact 23-bit hash): one load
    replaces the 32-slot scan per unmatched mcast frame under flood.
    Verified bijective; join/leave u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
    [esp_eth_mac_esp.c, flows_rx.c, flows_tx.c, net.c]
2026-10-14 Fix all critical/warning findings: clock error paths, ring invariants, USB ISR data safety, control-plane hardening
    Clock (Critical):
    - mc_hw_step/set_freq return bool; failed TSINIT no longer moves the
    epoch; servo keeps in-flight timestamps on failure; ptp_hw_*_fails
    telemetry; ptpv1 hook registration retried from ptp_task.
    Audio-path invariants (Critical/Warning):
    - ring head is monotonic (no producer-head regression on re-anchor).
    - eng_in_packet split stage/commit: failed usbd_edpt_xfer no longer
    silently consumes RX frames; arm_in commits only on success.
    - gap fill skipped beyond ENG_OUT_LEAD_MAX (was unbounded in gap, ran
    before the overrun re-anchor).
    - ARM-epoch guard swal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
    [aoip.c, aoip.h, aoip_host_stubs.c, aoip_internal.h, app_config.h, arc.c, check_iram.py, checksum_test.c]
2026-10-14 Audit of 0.1.0: fix four induced issues (build-error, NULL-deref, 2x Inferno compat); add CHANGELOG
    Deep re-review of the previous commit with reliability/performance/
    Inferno-compatibility lenses. Induced issues found and fixed:
    - usb/uac2_engine.h: prototypes missing for eng_stage_in_packet /
    eng_commit_in_packet — uac2.c calls them; the host tests and engine
    simulation don't reach the split pair (they use the combined
    eng_in_packet), so this was a bench-discovered build break. Added.
    - net.c net_udp_send_raw_ts: net_udp_dest_seal() ran before the
    argument checks — a NULL/invalid dest (API-legal) dereferenced.
    Seal now runs after the guards.
    - arc.c device rename: max name l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
    [arc.c, info_mcast.c, net.c, uac2_engine.h]
2026-10-14 Second review round: fix info-token-bucket clamp and RX fragment filter
    Bugs/edge cases + security review across the tree. Two Warning findings
    fixed:
    - info_mcast.c info_take_token: 'tokens > INFO_TOKENS_MAX - refill'
    underflows once a single idle gap yields refill >= 64 (any ~4 s quiet
    stretch); the else branch then added tokens uncapped, so idle periods
    accumulated unbounded free tokens and the next burst elicited an
    unbounded run of ~340 B info multicasts - the anti-flood limiter
    disarmed itself. Now always clamped, plus fractional-token carry so
    the documented 16/s ceiling is actually delivered under steady load
    (the old code lost up to one token per refill period).
    - net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
    [info_mcast.c, net.c]
2026-10-14 Review round 2: 8 findings fixed (TXT wrap, queue loss, startup state, mdns bounds, probe gate)
    1. TXT values wrapped before validation (must-fix): mDNS chan/bundle TXT
    parsing split into host-testable aoip/mdns_txt.c|h; every integer is
    range-checked before the u16 narrowing (1 <= id <= nchan, 16..32
    byte-aligned depth, nonzero/16-bit fpp pair, 16-bit ints, bundle
    address+port present, bundle ids/channels <= u16). id=65537 used to
    become channel 1 and get subscribed. New host test
    tools/mdns_txt_test.c (chan+bundle wrap/malformed vectors).
    2. Full command queue silently lost subscription changes: subscriber now
    enqueues first (bounded 250 ms wait), publishes visible st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
    [aoip.c, aoip.h, aoip_host_stubs.c, aoip_internal.h, aoip_mdns.c, app_config.h, arc.c]
2026-10-14 Audit of 0.1.3: revert the id<=nchan TXT bound, keep wrap protection, fix pool size
    Deep re-review of the 8-finding round with reliability / performance /
    Inferno-compatibility lenses. Three induced issues found and fixed:
    - aoip/mdns_txt.c (serious, Inferno compat): the new validation required
    1 <= id <= nchan, but the fork's nchan TXT is channels-per-flow
    (MAX_CHANNELS_IN_FLOW.min(channels) in mdns_server.rs), not the device
    channel count: a 32-channel device advertises nchan=8 while its ids
    run 1..32, and its client parses id unbound. The bound made every
    subscription to channels 9..32 of any 32-channel Inferno transmitter
    fail to resolve. Removed; the intended anti-wrap prot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
    [aoip_mdns.c, mdns_txt.c, mdns_txt.h, mdns_txt_test.c]
